OLLYDOTDEV/Project-Birdseye-DTX-2020/README.md

# Project-Birdseye-DTX-2020
The initial plan is to create a device that is made for the sole purpose of a Preemptive Security system for People who work with Confidential/Private Information and need to work on potentially more public places where one cant Guarantee fully secure/discrete room.    My Approach to solving this is with a wireless computing node  That Takes Sensor data from a variety of senses. Then the Data from the Senses is taken then and processed to determine whether there is a security breach if so then it will Relay that info over to the Raspberry Pi W that then Emulates an HID (Human interface device) Using the P4wnP1_aloa made by mame82 to Execute a custom user-defined action that will be set via  Apache server hosted of the Raspberry Pi W Communicating From a web interface back to the server via a web socket

 Projectbirdeye is out of the box working solution for this 
________
See for devlog of project [here](https://github.com/OLLYDOTDEV/Project-Birdseye-DTX-2020/issues?q=is%3Aissue+)
