OLLYDOTDEV/Project-Birdseye-DTX-2020/(threads)

Thread 2 (2020-06-03):

Atmega 328p

OLLYDOTDEV, 2020-06-03:
As a user
I want this to work out that is happened around the ROMS
why as the main point of this project is to work out whether there was been a breach of location as happened and react to it so something needs to calculate that something has happened.

OLLYDOTDEV, 2020-06-13:
Starting off to after I had worked out that I wanted to do  for this project

I was faced with how I was going to approach this component of The Project. From main projects, I knew that I was going to tackle the designing of the PCB with eagle cad but as for the actual device itself I had initially thought I would go with something like a raspberry pi zero w But decided that for something that is going to be run on battery power I would rather have something that is more efficient Powerwise, So I turned to look at Arduino’s and this was Looking around the promising option but the idea of having to buy A whole bunch of bunch sensors and also fit all compactly would have work but I was looking for something a little more flexible. I thought surely there is a better way to using Arduino, if Arduino was made from smaller Components surely I can do the same just have it more adapted to my project. So after further investigation, I have seen that The do we know Uno is based off the atmega328 DIP chip (Some clones use the TQFP version)

So when looking into getting an atmega328 to work first you need to burn the Arduino boot loader show in The variety of different ways here From Arduino to ATmega328. I will be using the FTDI Adapter Is something that needs to be kept the mind while doing this is the fact that The hardware pinout for this chip is

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

https://www.youtube.com/watch?v=kDL9CHratZE
This Image Shows the physical pinout of the chips but Confused and Confusingly the pin 1 of port pinout  does not Equal what can be seen for the function of the Pin as pin 1 Is a PWN pin Arduino is concerned it is pin ~D2

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

So next it to set up the needed external components see https://github.com/OLLYDOTDEV/Project-Birdseye-DTX-2020/issues/4

Closed 2020-06-15.

Thread 4 (2020-06-04):

External Components  (Atmega 328p)

OLLYDOTDEV, 2020-06-04:
As an electronics engineer
These extra components are needed to increase speed and stability for exected uses\
So that ROMS can be trusted as a security device by the user

OLLYDOTDEV, 2020-06-13:
continuing from #2

So there is the full layout for the pins. With this in mind, I am now proceeding to remake
https://www.arduino.cc/en/Tutorial/ArduinoToBreadboard
https://www.arduino.cc/en/Main/Standalone

Eagle Cad here I have added an image of the 16 MHz Crystal connected to ground

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

GIT[[added 16mhz +grounding](https://github.com/OLLYDOTDEV/Project-Birdseye-DTX-2020/commit/e12c5454263cb21ca886e1c202b559df976d1aeb)]

Crystal Oscillator work of the Piezoelectric effect. The Crystal needs to be connected to ground as crystal need grounding as when the crystal vibrates it can send a signal back down the connected wires to the ground nullifies these signals by redirecting them to ground The process of Grandma goes to a 20 microfarad Ceramic capacitor.
They provide a square wave signal which determines the time required for each T state

3.3v is Good for a max of 8 MHz
5v is Good for a max of 16 MHz

https://www.youtube.com/watch?v=YzcKQWwkzWs
https://www.elprocus.com/what-is-the-piezoelectric-effect-working-and-its-applications/

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
GIT[[added 16mhz crystal + grounding](https://github.com/OLLYDOTDEV/Project-Birdseye-DTX-2020/commit/93ae92d78ddcad249c48d75e36c7279c0da2040d)]

Here added is part of the Electrical relationships between VCC

GIT[[added .gitignore so that the temp .s#1, .s#2 files dont get uploard to upstream git repo](https://github.com/OLLYDOTDEV/Project-Birdseye-DTX-2020/commit/7e8b13f36523d23c00ed487ddc91489516e3ab27)]

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

Added reset headers that can be shorted to reboot the IC

GIT[[Start of NRF24lo1 hook up & LED](https://github.com/OLLYDOTDEV/Project-Birdseye-DTX-2020/commit/7bd8bc368a4d44dfbec3e38c69a0a2974c8d6d8c)]

next up #6

OLLYDOTDEV, 2020-06-13:
it should be noted that I will be running at 5v to allow my Atmega328p to run at 16 MHz giving me double the default processing speed and in turn quick reaction times removing one potential bottleneck, which is a critical consideration when time is at the essence do with security

Closed 2020-06-15.

Thread 5 (2020-06-07):

RGB Interface

OLLYDOTDEV, 2020-06-07:
As an engineer
this part of the IO Dedicated to sending signals to the LED on external PCB  needed
It is Impractical to LED's mounted directly on the main PCB and still has the LED display on the outside on the Protective case.

OLLYDOTDEV, 2020-06-13:
The initial plan was for the  display LEDs to be located directly on the main PCB  it was later decided that due to design restrictions it would be unlikely that you would be able to see the LEDs if they were located on the main PCB server the decision was made to make a secondary PCB to  how's the display LEDs that can be repositioned to the desired location when the case design is decided in #20

OLLYDOTDEV, 2020-06-13:
so with having an addition atmega328p on the secondary PCB (now called LC_Board)
To due lack of pins on the main atmega328p (for more info see #6 )
this atmega328p I have it dedicated to just controlling these lights and communicate via serial protocol back to R.O.M.S

OLLYDOTDEV, 2020-06-14:
Due to LC_board operations on 3.3v and the ROMS runs on 5v so when communicating over serial communication (TX and RX) pins on the used for this communication happen to also operate at the corresponding Voltages for each board. so I am going to need a real-time conversion unit eg something like [this](A Bidirectional Logic Level Converter (for I2C)) how they work[ explained here ](https://www.youtube.com/watch?v=t-yuYasIKtY&feature=youtu.be&t=349) Sparkfun does provide a [datasheet](http://cdn.sparkfun.com/datasheets/BreakoutBoards/Logic_Level_Bidirectional.pdf) on how there  [Bidirectioal logic level converter](https://www.digikey.co.nz/product-detail/en/sparkfun-electronics/BOB-12009/1568-1209-ND/5673795?productid=5673795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) would work as seen in the image below
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

OLLYDOTDEV, 2020-06-14:
In short how this work is frankly awesome

If you have 5v on the high end the then with the MOSFETs VGS being 0v (as both G and S are sitting at 3.3v there for no difference ) then the low will be pulled high and the low signal will be received as high but if the High was sitting at 0V then the MOSFET would turn on and the current would flow from low to high, and due to the fact that 3.3 is still counted as a logic high

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

Sure I Could I have you something like a dedicated chip with a 4-bit bus like a TXB0104

but the parts needed Logic Level Converter are also used in the rest of my project means that I happen to have his parts already on hand for when I do create it. So rather than being required to purchase another component, I could just use the surplus of my other components to achieve the same endpoint.

What is needed is a n channel MOSFET and a some 10K resters

OLLYDOTDEV, 2020-06-14:
First I needed to fix my eagle library for my MOSFET. This MOSFET .lbr from the git repo that I [sourced it](https://github.com/sparkfun/SparkFun-Eagle-Libraries/blob/master/SparkFun-Electromechanical.lbr) form as there where some labels that were missing on the n channel MOSFET

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
[before]

Here the pins are not labeled. To make this easier on myself so that I don’t have to keep working what pins are what. So here is the edited version

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
[after]

I didn't need to do this for the p-channel MOSFETs as they were all readily labeled on the Schematic
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

OLLYDOTDEV, 2020-06-14:
As for how the atmega328p on Roms will talk to the atmega328p on LC_Board we can look at how  Arduino's use with serial communication.

The **RXD** of the left PCB to the **TXD** of the right PCB
The **TXD** of the left PCB to the **RXD** of the right PCB

seen here
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

to starting of making the IO for the LC_Board

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

- GND is so that everything will have a common GND
- VIN allows to hook up to the battery input on the VIN pin this supports a max of 20v and around 1.6 A
-
- 5V_rail takes a pre knowen stable 5v this is used to provide power to for future version for latter projects, so it here for a future version that might need this so I am keeping my option open
-
- 3.3V_rail is for accepting a fixed input of 3.3 voltages or it can be used to be connected
-
- TXD is used for sending the serial data out from the PCB
-
- RXD_IN is for receiving serial data other from the PCB (refer to the 2nd image above)
-   to it opens
- Then there are two pins called 2BD this is short for to be developed And keeps my options open For further development
-

After Retrospect the IO needs a reset line for when hooking up my if FTDI chip (FTL232RL)for when I am to upload the program to the atmega328p chip. But that's why I added a 2BD(to be decided) pins
Here is an image of the  FTDI chip hooked up to an Arduino mini pro

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

So for my project this FTL232RL will connect to this pinouts

Here is CTS ,DTR ,BLK ,GRN. So before I continue, I am working out that these are.
So after talking with some people, it turns out that BLK & GRN if literally the color wire in the FTDI cable there are used for transmitting CTS and DTR data. CTS and RTS is used for a flow control, this is used for sending a high singal when the device is ready to receive more data but in my used case that is not needed.

CTS is ‘clear to send’ [this pin it not needed]
RTS is ‘ready to send’ [this pin is not used]

DTR is used for sending the reset signal to reboot the atmega328 chip once code has been uploaded

So here is my updated IO for the LC_Board
Git[[updated io](https://github.com/OLLYDOTDEV/Project-Birdseye-DTX-2020/commit/4a7a873846185fba254144686e5f116613a9eb19
)]
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

OLLYDOTDEV, 2020-06-14:
Added the reset in pin and also rearrange the layout so that it is a better match FTDI adapter.
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

Here I have haded the two headers for switching the input of RDI from being progressed as a 5v signal (jumper 2-1) on the left side and jumper (3-2) on the right. Whereas for 3.3v RDI input signage you want to put the jumper on the left (2-3) and on the right (1-2)

This is needed as the FTDI adapter will output an RDI of 3.3v. Were as the ROMS board will send a RDI of 5v that need to be converted to a 3.3v RDI before going to the Atmega 328p I have talk about how this will be done [here](https://github.com/OLLYDOTDEV/Project-Birdseye-DTX-2020/issues/5#issuecomment-643733966)

OLLYDOTDEV, 2020-06-14:
It should be noted that for LC_Board to run at [3.3v it will need to disable the brown out](https://arduino.stackexchange.com/questions/8733/what-are-the-implications-of-running-an-atmega328p-at-8-mhz-and-3-3-v-with-the-a) so what if doesn't to a chip force shutdown. http://www.engbedded.com/fusecalc/  lets you work out what to change.

OLLYDOTDEV, 2020-06-16:
With my change in plan as seen https://github.com/OLLYDOTDEV/Project-Birdseye-DTX-2020/issues/6#issuecomment-644453770  The interface will be changed to account for a new io to control the shift register

OLLYDOTDEV, 2020-06-16:
the changes that will be to be made for this interface are not to major as Shift Registers only need three pins for data (DS, ST_CP, SH_CP) and one 5v and GND. for the RGB I will still need 3.3v for it so I will keep it simply and use a level shifter make out of a 2K and 3k R resistor

OLLYDOTDEV, 2020-06-17:
To start [it is work reading this first](https://github.com/OLLYDOTDEV/Project-Birdseye-DTX-2020/issues/6#issuecomment-645112610). So with having the Shift Register in the LC_Board Schematic I am now about to see what Ports I need to use.

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

(IO)

For a start, I can remove the TXO, RXI, Reset_In and Vin pins this levels me with only GND and V5 pins

the three pins I need to hook up are
DS = data serial input // Found on pin 2
SH_CP =shift clock pulse // Found on pin 3
ST_CP = storage register clock pulse // Found on pin 4

 With those pins, I will be able to control everything I need to shift register with the STP16C596

A brief run down how the communication will be working
"How this all works is through something called "synchronous serial communication," i.e. you can pulse one pin-up and down thereby communicating a data byte to the register bit by bit. It's by pulsing second pin, the clock pin, that you delineate between bits. This is in contrast to using the "asynchronous serial communication" of the Serial.begin() function which relies on the sender and the receiver to be set independently to an agreed-upon specified data rate. Once the whole byte is transmitted to the register the HIGH or LOW messages held in each bit get parceled out to each of the individual output pins. This is the "parallel output" part, having all the pins do what you want them to do all at once." [arduino.cc](https://www.arduino.cc/en/Tutorial/ShiftOut)

OLLYDOTDEV, 2020-06-21:
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
(Updated IO)

Now with an IO changed to the new specifications.

Closed 2020-06-22.

Thread 6 (2020-06-07):

RBG LED’s

OLLYDOTDEV, 2020-06-07:
As a user
It would be highly convenient to have Device status feedback of the ROM'S
So what I Know that is happening and whether the ROM'S is ready to be used

OLLYDOTDEV, 2020-06-13:
https://octopart.com/598-8710-307f-dialight-868662#Specs
https://octopart.com/598-8710-307f-dialight-868662#PriceAndStock
Through many difficulties, I have managed to find CAD models and specs for the SMD RGB LEDs with the Component's name being 598-8710-307F. These LEDs are going to be used to output system status info to the user. Eg when batty need charing (also can send msg back to the computer and makes a pop-up, flash Red)

Design for this PCB is currently underway as LEDs.sch

the dialight LED's I am using happen to have 3 anodes per component once for each RGB LED
each of these anodes corresponds to a color, Eg R,G,B meaning to use the desired amount of three RGB LEDs that would require a total of 9 pins (1 per anode) on the ROMS atmega328p without having that amount of pins free it first thought I looked into was having on the additional PCB (as talked about in #5 ) an addition atmega328p microprocessor that acts as a node that branches off the Primary atmega328 allowing for the much-needed pins to control the LED's. https://github.com/OLLYDOTDEV/Project-Birdseye-DTX-2020/issues/5#issuecomment-643613012 will go into greater detail how this will work for connecting the two chips

OLLYDOTDEV, 2020-06-14:
I needed a way to control the first method that comes to mind. It is simply just powering the LEDs directly from the main IC(https://github.com/OLLYDOTDEV/Project-Birdseye-DTX-2020/issues/2#issuecomment-643586762 ). There should be there is that the atmega328p that I'm using operates at 5v and that would completely fry the leds as they are rated for about 3.4v

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
(The part name is DIALIGHT_598-8710-307F we can see that has 3 forward voltage values
This is for each of the three colors each there
And each color has a differce volage useds
)

OLLYDOTDEV, 2020-06-14:
A concept to approach in this issue was a plausible solution using Pulse width Modulation (PWM for short) On a half duty cycle of 5v it would hypothetically could maybe be averaged via a capacitor as seen [here](https://www.arduino.cc/en/Tutorial/PWM). I'm going to be inquiring to the teacher about this So that I can get a solid answer that way I can get a definite answer, ok well yes that has potential there is too many things I could go wrong with acting as an irregular power supply.
so after looking into this more yes it might work but firstly it would provide a way too much amperage as the LED at max can only handle 30mA and 5v from the Atmega328p can be at great as 200mA just under 20times. so it would be no good

OLLYDOTDEV, 2020-06-14:
https://github.com/OLLYDOTDEV/Project-Birdseye-DTX-2020/iissues/8#issuecomment-643705732
With using the LDO regulators going to control the voltages I can now get back to working out how to control the LEDs as stated in https://github.com/OLLYDOTDEV/Project-Birdseye-DTX-2020/issues/6#issuecomment-643615355 . Whats better to control something then a switch so how about an Electronics switch such as transistors
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

In short, a MOSFET is a Fancy transistor

but when comparing the base of a transistor to the Gate MOSFET can be seen that there is actually a physical connection where and drainage from that pin would occur would just be a waste of power. So An alternative is to utilize a MOSFET which utilizes The effect of inducing a current flow  via magnetic fields, once though capacitance is charged there's no need to continue providing power as there is no discharge, therefore, there is minimal to no loss-making it super-efficient Circuit

That is why I have picked MOSFET over transistors
So I started looking it to information about MOSFET
https://oscarliang.com/how-to-use-mosfet-beginner-tutorial/ was a good place that helped me a lot to understand how they worked

OLLYDOTDEV, 2020-06-14:
So for starting there are two types n-channel and p- channel
There are used in the two Different scenarios given below
(info from [youtube](https://www.youtube.com/watch?v=ZklK5DaIOaI))

In short, PNP is when the switch is placed be for the connected load, in my case, a MOSFET is out equipment switch. therefor the placed between the VCC of the load as seen here.
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
where as NPN is the opposite
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

There is also the mode that you need to consider as there are [two types](https://www.allaboutcircuits.com/video-lectures/mosfets-mos-field-effect-transistors/)

I will be going with enhancement-mode MOSFETs as in project is it is battery operated as having a content drain from a depletion-mode MOSFET (these are more like a variable resistor) would be the incorrect use for this component and Inefficient.
[Enhancement-mode MOSFETs](https://www.youtube.com/watch?v=l9LBIy9Ioxo)Work by when a sufficient voltage is applied to the gate (the amount of voltage changes from MOSFET TO MOSFET) it will Induce magnetic field in p material as the seen here.
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

Which in turn allows for current flow from the source to the drain. - in a circle is repetitive of current flow as electrons  are negatively charged
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

OLLYDOTDEV, 2020-06-14:
So with this in mind this there is more to consider when picking a MOSFET for your project

Gate threshold otherwise knowen as [Vgs(th)](https://www.allaboutcircuits.com/technical-articles/understanding-mosfet-on-state-drain-to-source-resistance/) is a point where the MOSFET will start to conduct current but with high resistance. gate-source voltage is scaled to allowing more current through once your parcel point. eg within a given range more volage at Vgs(th) =  Is an inverted depletion curve ratio.
[Understanding MOSFET On-State Drain-to-Source Resistance - Technical Articles](https://www.allaboutcircuits.com/technical-articles/understanding-mosfet-on-state-drain-to-source-resistance/)
[Topic: n-channel / logic level / low Rds MOSFET - and datasheet questions](https://forum.arduino.cc/index.php?topic=465934.0)
[n-channel / logic level / low Rds MOSFET - and datasheet questions - Page 2](https://forum.arduino.cc/index.php?topic=465934.15)
[Topic: About the good usage of N-channel MOSFET ](https://forum.arduino.cc/index.php?topic=51916.0)

[RDS(on)]( https://www.youtube.com/watch?v=P_5kPfwzT80) idea seems simply when the gate is off the resistance between source and drain is extremely high—so high that we assume zero current flow. This scales as more voltage applied to the gate pin the more current can flow through from Source to drain (Until blows itself up due to much voltage, not recommended )

Logic level MOSFET vs normal MOSFET
[MOSFET Confusion - Logic Level vs. Standard
](https://www.avrfreaks.net/forum/mosfet-confusion-logic-level-vs-standard)
[Logic level vs "normal" MOSFETS](https://www.electro-tech-online.com/threads/logic-level-vs-normal-mosfets.91756/)

to put it simply means what the Mosfet runs from the approximate 3.3 to 5-volt value on the [gate to Source ](https://electronics.stackexchange.com/questions/75516/determining-the-maximum-gate-voltage-for-an-n-channel-mosfet
)Rather than higher values like 10v switch and microcontrollers typically don't normal output natively higher than logic level voltage.

So as long as the RDS(on) Met in the gate is provided sufficient power Then we should be fine
This is important as I will be needing To drive MOSFETs at a logic level (3.3v or 5v) so the RDS(on)

Here's a breakdown some [Main parameters of a MOSFET](https://www.embeddedrelated.com/showarticle/809.php)
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

OLLYDOTDEV, 2020-06-14:
Making sure that you use the right specs for a project is important to know. this info can be obtained by looking at graphs. To confirm my finding I talked to someone who works in the electronics industry.

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
(Conversation took place 20/02/20: 9:50 pm with A certified  electronics engineer with a degree from university who is actively working in the industry as well)

Armed with this knowledge I feel I'm able to make an informed decision on watch component more explicitly which MOSFET would be the best option for my particular use-cases while considering things like budget, usability, flexibility, and accessibility

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

OLLYDOTDEV, 2020-06-14:
I will be going a SOT-23 footprint due to its sizes so the two MOSFETS I am looking at getting will both work at 3.3 and 5 Volts making them very Versatile and reusable within this project. for my N channel MOSFET, I will be using a [N channel: BSS138](https://nz.mouser.com/datasheet/2/308/BSS138-1300116.pdf)
and for my P channel MOSFET, I will be using a P channel: [DMN65D8L](https://www.diodes.com/assets/Datasheets/DMN65D8L.pdf)

OLLYDOTDEV, 2020-06-14:
here it was the RBG LED look with when hooked up to MOSFETS within Eagle CAD schematic view
(the gate voltage for the MOSFET is driven by the digital pins on the atmega328 )
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

Below is the pinout if the atmega328p
The brown pins with 0 to 13 are all digital pins i could use.
But due to the fact i am also going to need some of this for the serial interface for connection with the R.O.M.S these pins are the RXD and TXD pins i made a note not to use them
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

I have selected pins (D then the number is The corresponding pin on the atmega328p)-(this is the color it is controlling)

D5 - Red -
D6 - Green -
D7 - Blue -

D8 - Red -
D9 - Green -
D10  - Blue -

D11  - Red -
D12 - Green -
D13 - Blue -

As according to this datasheet anyway
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

OLLYDOTDEV, 2020-06-14:
After used eagle cad to take the prior defined Electrical connection from my schematic file and then used the parts footprints and converted them into a .brd file this file is used for defining the physical relationship for the parts and physical wires.

They started all jumbled but after some Shuffling of parts this is what it looks like
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

Here we can see that i cam starting to get the parts into there groups

Eg

Power, Led, io, etc

All the yellow lines that can be seen are called air wires. These are used to Show the electrical relationship between components that define the physical wires between them.  the routing tools used to add the physical wires. In a relatively simplistic Circuit like this then you can use a function called autoroute which essentially utilizes the computer to generates the most efficient pass between components without having any overlaps.
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

Above you can see the outcome of utilizing autoroute did a pretty decent job of looking at everything consider That I had to place only components in Rough groups.

After revision, I have looked at all other Opportunities to Start shrinking my board design and optimize it more here is the next revision

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
On the left, I have compressed the headers for selecting the 3.3 volts or the 5-volt RDI as well as trying out a new method of compressing the LEDs and MOSFETs on the right.

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

Again compacting the left side down more while trying to maintain it at a scale which I can still realistically make my hand

OLLYDOTDEV, 2020-06-14:
Seeing as I want the LED to be flush with the case where I needed to move the led from the top of the PCB (red color) to the bottom (blue color).
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

Here on the (image above), I have moved the RGB LEDs to the back as seen in blue. The wires were placed by autorouter and are very messy. The need for the wiring to be tidy is the PCB at a later date. So to achieve this I will wire this by hand.

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

The (image above) there is an image of my manually Connected wires that have resulted in a Uniform Circuit Layout.  So yes sometimes it does pay to do things by hand. [Spark fun guide](https://learn.sparkfun.com/tutorials/using-eagle-board-layout/all) helped a lot here on how to do a good looking job. If if you compare the image just above to the one above the image that contains all 9 MOSFETs  you will see a major difference in the layout
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

Here is everything looking nicely wired by hand

OLLYDOTDEV, 2020-06-14:
Throughout the process of green the PCB, I may have renamed some names without the schematic editor open therefore they became essentially two different versions of this PCB and the result is that the difference is created and one edited did not sync to the other and earn of this I now have to go through manually fix errors, to prevent this in the future from happing I need to have a feedback loop enabled this can be simply achieved by just have the Schematics editor open as well as the board editor

 open at the same time
as fixing this was a poor use of my time 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
GIT[[Syncing schematic with board fixed](https://github.com/OLLYDOTDEV/Project-Birdseye-DTX-2020/commit/0adb82384fae904a645e03be3eee91c073322475)]

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

Git[[R1 Finish (yet to test)](https://github.com/OLLYDOTDEV/Project-Birdseye-DTX-2020/commit/026b4fea1fb36c3496c9733880ad8f4e927f4855)]

Here R1 for LC_board is complete and parts need to order so that construction can commence, till then see Construction process to see the physical development of this board

(added all needed part to part list on google sheets found in 2020 DTX For Oliver page Components and power calculations.)(at time of write this it is on google drive but will be backed up to GitHub once the project is complete )

Also with this daughter board of the ROMS designed. The next step in to continue the ROMS PCB  designing so I can then continue with the construction process

OLLYDOTDEV, 2020-06-16:
After the sprint review (with me. myself and I), it was noticed that while the proposed design work would and achieve the aim of the user story. Between when I started designing this part of the project found a circuit called [shift registers](https://www.arduino.cc/en/tutorial/ShiftOut).This would allow me to make LC_Board cheaper, simpler, and even better it will make it easier to produce. Therefore this second sprint I will be focusing on remaking LC_board to use a shift register.

OLLYDOTDEV, 2020-06-17:
To start off with the shift registers I will be changing my the IO from [#5](https://github.com/OLLYDOTDEV/Project-Birdseye-DTX-2020/issues/5#issuecomment-643737385) and also removing everything else other then the LED from the Schematic. Next, I need to add my level shifter, the level shifter I have picked to use is the STP16C596 in the TSSOP24 SMD package. I have chosen this chip over other mainstream chip such as the 74HC595 due to the need to use 9 pins and a chip like 74HC595 can only control 8 pin so have gone with the STP16C596 it can control 16 pins all at once, yes you are able to just use two 74HC595 but I am trying to keep down the cost as this is an implication that I am keeping in mind so using two 74HC595 would firstly cost more and also would take up more space there for making the STP16C596 a better choice.

but the next issue I found was that STP16C596M doest have a part file for eagle cad so as a fix to this I made my own on [https://ms.componentsearchengine.com
](https://ms.componentsearchengine.com) from this I was able to generate STP16C596M.lbr this can be found in Project-Birdseye-DTX-2020/Schematics/libraries/STP16C596M.lbr

with this, I was now able to import the IC into the LC_Boad.sch

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

OLLYDOTDEV, 2020-06-21:
Ok so with the IO needed for the level shifter sorted out in https://github.com/OLLYDOTDEV/Project-Birdseye-DTX-2020/issues/5#issuecomment-647071016 it connects them to the IC. To do this we can look at Table 3 on the STP16C596M [Datasheet ](https://www.digchip.com/datasheets/download_datasheet.php?id=938538&part-number=STP16C596B1R)

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

From here it can be seen that Power Pins are
GND = Ground terminal // Pin 1
SDD = Supply Volage Terminal // Pin 24

From here it can be seen that that for the main input- pins that we care able are

SDI= data serial input //  Pin 2
SH_CP =shift clock pulse // Pin 3
ST_CP = storage register clock pulse // Pin 4

Data Pins that would tied to a fixed voltage
/OE = Output enable // Pin 21 // PUllED DOWN LOW

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

These pages were used to check the pin hook up to the [datasheet](https://www.st.com/resource/en/datasheet/cd00005085.pdf) as it is better safe than sorry.
https://phanderson.com/arduino/stp_596.html
https://www.arduino.cc/en/tutorial/ShiftOut

OLLYDOTDEV, 2020-06-22:
now time to get back to hooking up the LEDs so they can be controlled. Now knowing that STP16C596  has 16 togglable outputs, at first it was my thought to connect the anode (positive) then bam but yeah no , if only things were that easy.
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
(Common anode RBG LED)

well they would be it I was using an RGB led with a Common Anode (shown above) but it is cheaper at get a Common cathode RGB LED as (shown below) there for keeping within the implications of this project I am keeping the costs down.

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
(Common cathode RGB LED)

To my approach to this is use the fact that the + of current to the point of low charge (eg Ground or the Negative of a battery) So by connecting the output pins from the STP16C596M  in the cathodes of the LED's I will be let me control the flow of the current. When a pin for the Shift register is high(5v) then there will be greater (due to STP16C596M  running at 5v and the LED at only 3v) electric potential difference there for with no current flowing the LED and in turn, will turn off. Whereas if the pin from the Shift register is set to low then there will be an electric potential difference thought the LED and current will flow and hence the LED will produce light. Sure yes it is  backward to how one would normally think to turn on and off of LED but it should work (prototypes of example circuits were used to test the therory behind this) have the control be inverted is no issue due to the fact that code https://github.com/OLLYDOTDEV/Project-Birdseye-DTX-2020/issues/7 will be able to compensate

OLLYDOTDEV, 2020-06-22:
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
Here the LEDs have been connected to OUT put pins Shift register. I have done as much testing as I can with parts I have on hand put the key to this is yet to be tested. the Key is for the Shift register to be bidirectional so when they are not providing power they hopefully and act as a path to ground. this will be tested one the shipment of parts has arrived still then this sprint is at an end and will need to be reopened once the appropriate components in unavailable to be tested/prototyped

https://github.com/OLLYDOTDEV/Project-Birdseye-DTX-2020/commit/38e38a723ac9d003f8767095b455d9875b63956c

Closed 2020-06-22.

Thread 7 (2020-06-08):

LED control code

OLLYDOTDEV, 2020-06-08:
As a programmer
I need to add some control code to convert the current drive status to a LED output
So the LED's added in https://github.com/OLLYDOTDEV/Project-Birdseye-DTX-2020/issues/6 will be able to reflect the Current drive status

OLLYDOTDEV, 2020-09-23:
dim unnecessary to develop while still on Prototype stage in the did not provide the most value to the customer/due to the ad job process trying to provide whatever is going to provide the most value to the customer

OLLYDOTDEV, 2020-09-23:
never left prototype stage from the breadboard combined with the project running out of time the it'll be no longer developed

Closed 2020-09-23.

Thread 8 (2020-06-09):

Battery

OLLYDOTDEV, 2020-06-09:
As a user
There needs to be some way that ROM's from work without the need for it to be plugged directly into the source of external power.
So a fix would be to add some sort of battery to the system

OLLYDOTDEV, 2020-06-13:
At first when Research started into providing power to ROMs it was decided that there will need to be some sort of capacitor to smooth out the waves  coming from the power source As the act a bit of a Reservoir  as in when there is a lack of energy days are able to provide a small boost and when there is the increased it is able to absorb some of that excess energy

OLLYDOTDEV, 2020-06-13:
Talk more about the physics behind sine waves and Pulse width modulation
https://www.allaboutcircuits.com/textbook/alternating-current/chpt-7/square-wave-signals/
Square waves are equivalent to a sine wave at the same (fundamental) frequency added to an infinite series of odd-multiple sine-wave harmonics at decreasing amplitudes.

OLLYDOTDEV, 2020-06-13:
That then raises the question of how I am going to power the ROMS and its core components #2 , #4
For this, I will be needed to provide two volage levels a 5v rail and also a 3.3v rail so for this I thought I would play it on the safe side and use two [CR2032 - 3V](https://www.aliexpress.com/item/32894761648.html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,searchweb201602_,searchweb201603_) due to there small size and a total output of 6v or does it
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

Volage discharge rate chart (top image)
CR2032 N placed in series resulting in 6 volts (bottom image)

As seen in The image above initially the coin battery starts off what's above 3 volts around 3.2v. Since I will be running two of these and parallel will give me 6.4 When fully charged (new) And this could completely fry any regulators if you were just basing the typical output on his average discharge voltage. So where I had initially thought hey 3 + 3 is 6 OK let's get a regulator that is writing for a maximum of 6 volts recalculating and with that I needed the minimum  Of at least (having more overhead is find )7 volts best safe So not too fry my components as the only rated for Max of 5 volts or 3.3v. To prevent this I am looking at USING two  3.3 (for this led PCB,https://github.com/OLLYDOTDEV/Project-Birdseye-DTX-2020/issues/6#issuecomment-643615355,https://github.com/OLLYDOTDEV/Project-Birdseye-DTX-2020/issues/5#issuecomment-643613012) and 5 volts (for ROMs,https://github.com/OLLYDOTDEV/Project-Birdseye-DTX-2020/issues/2) regulators

Now time to research more sort of regulators there are out there and what suits my purpose best

OLLYDOTDEV, 2020-06-14:
After coming back from https://github.com/OLLYDOTDEV/Project-Birdseye-DTX-2020/issues/8#issuecomment-643615584 and looking into regulators I have found that there are 3 Primary types of [Voltage Regulators ](https://www.lifewire.com/types-of-voltage-regulators-818851)

Linear Regulators
Switching Regulators
Zener Diodes
[Buck converts](https://en.wikipedia.org/wiki/Buck_converter)

In the end, I Decided To go with a Low dropout Linear Regulators. So I due to the fact that my input voltage of 6v is close to the 5v I can Afford to use Low Dropout Linear (LDO) otherwise the heat as any extra voltage is converted to heat so with having only

The main pro with this is the fact that they are simple/cheap / produce low noise as just said the only issue is that any excess voltage gets turned into heat there for giving them limitations and but this is not an issue in low voltage appliances where the low supply voltage and is close to the voltage out and when you require low noise environment. Which is exactly my use case.

From past projects, I have found that a good place to start of looking for parts is [Digikey](https://www.digikey.co.nz/en/product-highlight/s/stmicroelectronics/ldo-regulators
LDO)(Low Dropout Linear Regulator)

After looking on Digikey and not finding what I am looking for I took to google
And found [this page](https://www.analog.com/media/en/technical-documentation/data-sheets/1763fh.pdf). It houses the datasheet for a series of LDO’s

I have a choice to use
LT1763CS8-3.3 to provide 3.3v rail and LT1763CS8-5 for 5v rail
These LDO have 8 pins, four each side.

These pins are
BYP (Pin 6/Pin 4)
 achieve low noise performance from the regulator if not used do not connect pin
06

IN (Pin 10, 11/Pin 8)
(VIN is the completely unaltered input power before the regulator)

Power into regulator
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

I will be Replicating the circuit in below in Eagle for
LT1763CS8-3.3
And
LT1763CS8-5
Libraries have also been added
LT1763CS8-3.3_TRPBF.lbr
And
LT1763CS8-5TRPBF.lbr
So that the schematic has the needed parts from the [datasheet](https://www.analog.com/media/en/technical-documentation/data-sheets/1763fh.pdf)

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

 The bypass pin is not utilized due to the fact that it is only needed for when you're trying to achieve lower noise to Signal ratio and these LDO all ready have a signal to noise sufficient to my needs

it should be noted that it was considered to uses
resistors to make a volage to make a voltage divider to drop the volage

OLLYDOTDEV, 2020-06-14:
With the [power delivery designed ](https://github.com/OLLYDOTDEV/Project-Birdseye-DTX-2020/issues/8#issuecomment-643705732) The now I need to implement it to my schematics
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
Some other things to keep in mind is that I also need to take 6v From ROMS to the LC_Board via #5

It was thought able having the 3.3v regulator on the ROMS then send 3.3v to LC_board but It

It occurred to me that rather need to redesign a very similar item in a future project that it should be designed to be able to work independently of other components and be a standalone subsystem as will be seen in #6 .

OLLYDOTDEV, 2020-06-14:
This marks the completion of Of the first implementation of the Schematic
git([power system for the LED](https://github.com/OLLYDOTDEV/Project-Birdseye-DTX-2020/commit/8a63fe896f22e3a90d1ba206198f2dcbb4598356))

OLLYDOTDEV, 2020-06-16:
So after viewing at the end of sprint meeting with my self I work out that some of the need parts for the battery/power system can no longer be brought due to COVID-19

https://github.com/OLLYDOTDEV/Project-Birdseye-DTX-2020/issues/11#issuecomment-644455695 so no longer with access to my first choice of power regulators I am will have to drop the supplied voltage to the ROMS PCB down to 4.5v from 6v. 4.5 voltages will be provided by 3 AA batteries giving around a nominal voltage of 1.5 voltages * 3 gives me the needed next best case.

To deal with any power fluctuation I will use a 10uf 50v capacitor to normalize the output voltage by holding any extra check that might occur with a power spick but also hold some charge so that if there is a small dip in the output voltage it is able to make up for the lost of voltage and keep it at an equilibrium

Closed 2020-06-22.

Thread 9 (2020-06-09):

Battery Meter

OLLYDOTDEV, 2020-06-09:
As a user
ROMS should be able to show the user what the battery charge is
As otherwise there is a risk of ROMS powering down due to lack of power and in turn not performing as expected

OLLYDOTDEV, 2020-09-23:
never left prototype stage from the breadboard combined with the project running out of time the it'll be no longer developed

Closed 2020-09-23.

Thread 10 (2020-06-10):

Voltage level reading

OLLYDOTDEV, 2020-06-10:
As engineer
To use the added Hardware of the Battery Meter from https://github.com/OLLYDOTDEV/Project-Birdseye-DTX-2020/issues/9 I need to have a conversion layer so that analog voltage is converted to values that is able to be used by https://github.com/OLLYDOTDEV/Project-Birdseye-DTX-2020/issues/7 in turn showing the status of the device.
So that there is more useful data can be displayed   .

OLLYDOTDEV, 2020-09-23:
never left prototype stage from the breadboard combined with the project running out of time the it'll be no longer developed

Closed 2020-09-23.

Thread 11 (2020-06-10):

Power Regulation

OLLYDOTDEV, 2020-06-10:
As an Engineer
To prevent a hardware/ software failed as this can happen due to unreliable power fluxation
So having something to Regualat the provided power would, in turn, make this a more reliable platform

OLLYDOTDEV, 2020-06-15:
this was solved in https://github.com/OLLYDOTDEV/Project-Birdseye-DTX-2020/issues/8#issuecomment-643615584

OLLYDOTDEV, 2020-06-16:
due to COVID-19 some changes to are going to be able made as I no longer can buy the needed Power regulator.

OLLYDOTDEV, 2020-06-17:
https://github.com/OLLYDOTDEV/Project-Birdseye-DTX-2020/issues/5#issuecomment-644662839 I bring up the fact that I will still be using 3.3v on the LC_board but I won't have a voltage regulator on it so I will be using a voltage divider. to calculate the value of the needed resister I will be using
this formula
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
to make my life easier I will be using this [voltage divider calculator](https://www.allaboutcircuits.com/tools/voltage-divider-calculator/ )

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

so with an input Vin of 5v
If it set R1 to a 2K Ohms
and R2 to 3k Ohms
With these values
Giving a Vout (output voltage )of 3 Voltages Which is within the save usage range for my LEDs

OLLYDOTDEV, 2020-06-21:
Power for LC_Board will be coming from the primary PCB from within ROMS.  As said https://github.com/OLLYDOTDEV/Project-Birdseye-DTX-2020/issues/11#issuecomment-645130640 I will be using a voltage divider,  in doing so I take my 5v_Rail from the [IO](https://github.com/OLLYDOTDEV/Project-Birdseye-DTX-2020/issues/5#issuecomment-647071016)
and hook it up to the voltage divider giving be the needed voltage to
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
here is the voltage divider made Eagle cad within LC_Board.sch

Closed 2020-06-22.

Thread 12 (2020-06-10):

Sensors

OLLYDOTDEV, 2020-06-10:
As an end-user
I need ROMS to be able to detect in a variety of situations. in turn, be able to handle the information for the Sensors depending on the situation.
This is so that any private/secure information is protected.

OLLYDOTDEV, 2020-06-25:
While working out what IR sensor I was going to use for #14 I happen to run need to run some tests for this there was some test code that I produced.  See https://github.com/OLLYDOTDEV/Project-Birdseye-DTX-2020/issues/14#issuecomment-649520131 for more info about what it does but this code. It is most likely that some version based on this code will be using when developing this full code for the sensors

OLLYDOTDEV, 2020-06-25:
https://github.com/OLLYDOTDEV/Project-Birdseye-DTX-2020/issues/14#issuecomment-649520131

OLLYDOTDEV, 2020-06-29:
if (IRdatacount >= IRcheckcount) {

}

So I started off looking if anyone had made the code I was looking for everyone seemed to say that is what I was looking for [http://www.arduino.cc](http://www.arduino.cc/en/Tutorial/Smoothing)

so I have it a test

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

and it worked flawlessly as there is no dips in my values, am I surprised not really as this code is found on the official Arduino page
```
/*
  Smoothing

  Reads repeatedly from an analog input, calculating a running average and
  printing it to the computer. Keeps ten readings in an array and continually
  averages them.

  The circuit:
  - analog sensor (potentiometer will do) attached to analog input 0

  created 22 Apr 2007
  by David A. Mellis  <dam@mellis.org>
  modified 9 Apr 2012
  by Tom Igoe

  This example code is in the public domain.

  http://www.arduino.cc/en/Tutorial/Smoothing
*/

// Define the number of samples to keep track of. The higher the number, the
// more the readings will be smoothed, but the slower the output will respond to
// the input. Using a constant rather than a normal variable lets us use this
// value to determine the size of the readings array.

const int numReadings = 20;

int readings[numReadings];      // the readings from the analog input
int readIndex = 0;              // the index of the current reading
int total = 0;                  // the running total
int average = 0;                // the average

int inputPin = A3;

void setup() {

  pinMode(inputPin, INPUT);
  // initialize serial communication with computer:
  Serial.begin(9600);
  // initialize all the readings to 0:
  for (int thisReading = 0; thisReading < numReadings; thisReading++) {
    readings[thisReading] = 0;
  }
}

void loop() {
  // subtract the last reading:
  total = total - readings[readIndex];
  // read from the sensor:
  readings[readIndex] = analogRead(inputPin);
  // add the reading to the total:
  total = total + readings[readIndex];
  // advance to the next position in the array:
  readIndex = readIndex + 1;

  // if we're at the end of the array...
  if (readIndex >= numReadings) {
    // ...wrap around to the beginning:
    readIndex = 0;
  }

  // calculate the average:
  average = total / numReadings;
  // send it to the computer as ASCII digits
  Serial.println(average);
  delay(1);        // delay in between reads for stability
}

```
for anyone who does under here a good brack down on [how it works](https://www.programmingelectronics.com/tutorial-23-smoothing-data-old-version/)

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

now that is a big change mainly from the fact that we can see that our noise floor is now above 60, therefore, increasing the reliability of the values that we receive hopefully reducing/ if not completely removing all values that would give false positives.

OLLYDOTDEV, 2020-06-30:
it was all so considered to use a system that works on the bases of this pseudo code
```
first, remove key 0 of array
shuffle all key of an array down
add a new key with new sensor data

get a total of all the key added together
then take a total and divide to get the average
```
while in theory, this would work if I wasn't using a microcontroller with 2K of ram but I am so in the interest of to saving processing power and storage I will not be using a shuffling method also note that C++ is not made to be used dynamically but rather fixed (this decrease the needed resource overhead and means that this is great for IC ) as one an array has been made with a fixed amount of values you can't easily change the array to have less or more keys but only change the content of the data at key value.

OLLYDOTDEV, 2020-07-03:
I had mentioned that #14 I could get a 32 cm Range but that was under lightly controlled conditions but ROMS  is not going to be used in a controlled environment and hence the real-life in day to day environments are more like  3 to 8 cm as every environment is slightly different to the next to fix this the sensor could be recalculated automatically but adjusting the potentiometer, in that case, it would make sense to use a digital potentiometer that can be controlled by an atmega328p. now this would have a layer of complexity that while it would allow for the greater flexibility due to increased range as hoped for it is more practical to use a more reliable signal at the cost of range via

1. having a default setting where it is ok in most environments
or also having the option
2. to configure the IR sensor manually if better range is needed

OLLYDOTDEV, 2020-07-07:
So something I have found is that old light bulbs happen to give off IR light off that means that I can no longer to option one and I need to have a setup config mode as one of my relevant implications functionality in this case functionality is being flexible to work and multiple locations without restrictions

OLLYDOTDEV, 2020-07-07:
So while the IR sensor I am using does have an ADC onboard I am not happy with the value that it considers a low and high therefor I am reading the raw sensor data and give me the ability to control what is considered a 0 or 1[here is the code I used](https://github.com/OLLYDOTDEV/Project-Birdseye-DTX-2020/commit/ca5416f2f532c82813f2800dc5807e405ef67729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) next is to add a configuration mode where rather to sending out values it calibrates self

OLLYDOTDEV, 2020-07-07:
the calibration function has been now implemented the variable calibration_trigger controls whether or not the sensor will stay with local environment to set the IR sensors sensitivity or. it will pass on the signal to the relay
1 = calibration mode on | 0 = calibration mode off

to calibrate the sensor
put ROMS the desired Max distance a value under 12 cm is good
then turn the potentiometer on the sensor clockwise till it can be turned clockwise no more
next slowly turn anticlockwise to indicator LED turns off
then turn clockwise again just enough for the led to turn back on
DONE
 the sensor is calibrated for the environment

OLLYDOTDEV, 2020-07-07:
example on how to calibrate is shown here
https://youtu.be/vRiN55FDCng

OLLYDOTDEV, 2020-07-17:
This issue and #13 have been moved to milestone 4 (sprint 4) as the time need to complete them undercalulated and they needed to be moved to the next sprint as they at what provides the move value.

OLLYDOTDEV, 2020-07-19:
here is the sensor subsystem. it has been making to keep working and send keep send data so that whenever that when if the atmega328p does error out when it comes back up it the sensor all ready power on while this does have the drawback of some power loss due to Quiescent Current. the trade-off is worth it as 3 seconds mean all the difference.  When fist started off I had thought to try and minimize quiescent Current to try and maximize the battery life but in this latter version I am just keeping parts like the PIR and IR sensor powered so that as soon as the control IC is online we will be in back to business is is acceptable as the sensors picked in #13 and #14 both have low  Quiescent Current.

OLLYDOTDEV, 2020-07-19:
with the hardware for here sorted it is time for being.

I need to bring the software together that sets a state of being triggered which then can later be detected with #17.

OLLYDOTDEV, 2020-07-19:
in short this stage sorta just take parts from my test code and mergers in together.

so my taking pir_test.ino, IR_Sensor_Conf.ino, and SMOOTH_DATA.ino
(all off these files can be found here in the Project-Birdseye-DTX-2020/CODE/TESTING)

code from pir_test.ino will be used to control the input from the PIR sensor

from this here is what needs to be done
- [ ] add boolean for whether the PIR sensor has been triggered or not
- [ ] adapt IR code to use a boolean
- [ ] make SMOOTH_DATA.ino into a function

OLLYDOTDEV, 2020-07-21:
explain more on the smooth data. it is what I am using on the IR sensor to make my reading more accurate by taking an average over an amount of time. The base of this code was found open-source here  http://www.arduino.cc/en/Tutorial/Smoothing

starting to I need to make it function. todo this need to first make it so that values to be pass to the function to latter have an output return the smooth data

OLLYDOTDEV, 2020-07-22:
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
here is the basis of a function.

so I'm my case for the parameters I am using are is readings is all that would need to be passed

OLLYDOTDEV, 2020-07-22:
change of plan instead of making a function I will be using object-oriented programming and uses a class to make a blueprint as such as needed for the likes of 2.7 for NCEA but it also has the added benefit of allow me to reuse this class on more then one sensor if needed in the future keeping my options open for later development or for future developers spick up and continue the project as this is open source as accessibility in open source and just general availability to everybody as one of my implications

OLLYDOTDEV, 2020-07-22:
while testing on how to get class's to work I have moved this testing into a new file called Smoothing_class_test.ino
once this is working I can copy the working parts of the code i need into the main full test file

OLLYDOTDEV, 2020-07-23:
here you will find my test [file](https://github.com/OLLYDOTDEV/Project-Birdseye-DTX-2020/blob/38f92176e339dc9b9d3086bd4498b3718d2488ed/CODE/TESTING/Smoothing_class_test/Smoothing_class_test.ino).

in short, the point of it is test was to see how the structure for the copy for a c++ class would integrate into my project. Gudies online prooved mainly unhelpful with assisting this it was found to be more useful to take the [example code ](http://mypractic.com/lesson-7-classes-in-c-language-for-arduino-button-as-an-object/ ) and reverse engineer. Due to not having access to my hardware, I can't test if this code produces the same desire output. this will be done latter tonight

OLLYDOTDEV, 2020-07-23:
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
and here we have with a working version off data smoothing as found on http://www.arduino.cc/en/Tutorial/Smoothing but rather in the manipulated into a form of a class to increase for future flexibility for me for other developers.
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
to check that that the code had been correctly converted to be used as a class i am using DDT or otherwise known as test-driven development.

OLLYDOTDEV, 2020-07-23:
so with this get up there is an example of how the class works.

to make a object for it is a easy as

 Class name       object name (of you choice)
`AnalogSmooth IRsensor; `

now that we have a object name
we just need to call that object name  + the method we want to use

so ` IRsensor.Smooth_setup();` and BAM the IR sensor is set up and ready to have its input be smoothed and have some of the extra noise removed.

OLLYDOTDEV, 2020-07-23:
next step is to take this smoothing code and add it into the main testing code as talked about here https://github.com/OLLYDOTDEV/Project-Birdseye-DTX-2020/issues/12#issuecomment-660609183

OLLYDOTDEV, 2020-07-23:
well adding the smooth class to the header file went smoothly and there was no issue with it. but having a reliable data source revealed that the logic for the code was floored and needed to be revamped. eg i missed name a variable and was when it was looking if a status went high it would loop as once it was toggle high there was no method and plays for it to be reset

so started off I have added a part just for debugging to allow me to find issues with more ease with developing this code

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
verbose debug

otherwise here is the heart of it
``` C++
// IR code
IR_DATA = IRsensor.Smooth(IR_OUT);

if(IR_DATA < IR_Threshold){
// if this if statement activates that means that the sensor has been triggered
IR_Status = 1;
}else{
IR_Status = 0;
}

// pir code
Pir_Data = digitalRead(Pir_Out);
if(Pir_Data == 1){ // if PIR sensor actavated then set the alert status to active (true)
Pir_Status=1;
}else{
Pir_Status=0;
}

if(Pir_Status || IR_Status == 1){
Alert_Status = 1;
// then send out alert to relay
// sensors have been triggered
}else{
Alert_Status = 0;
// no sensor actived no nothing
}
```
this just allows the atmega328 work out that sensors have been triggered.

it all works all and great
as if either of the sensors gets activated the alert status is activated that will in time link into the #17

but it has one issue and that is the fact on startup IR Data is all way at the around of value of 110
see [pastbin](https://pastebin.com/c0YugAxK) for full log. but in short, it starts at a low value and slowly fills up the array smooth before stabilizing.  further investigation will be conducted tomorrow.

OLLYDOTDEV, 2020-07-24:
So first off before I can fix the issue I must work out what is the cause of the issue. The issue was found by looking at the output of the variables that get utilize with averaging in the smooth.h file

the point where the error was found was here `  _average = _total / _numReadings;`  this line of code takes the total of the past
x reading and calculates the average value (hence the class name analogsmoothing)

So ways to counter this there was a handful of options considered.
1. change the values of assisted variables. In this case, the only variables that have an effect on the average value are  _total and _numReadings and editing these would brake the rest of the system there for this rules out this option,

2. fully rewrite the logic of the averaging system. the rest of the system is just fine so no need to remake the whole thing to just get this small part to work so I won't be using this.

3. wait for x time (eg 10sec ) worth of data to pass be for allowing the alert system to be activated. Yes is an option that can work but I reckon I can find a quicker more time-efficient method.

4. once x amount has values have pasted then allow alerts to be sent. I have decided to go with a variation of this sort of design.

OLLYDOTDEV, 2020-07-24:
my first attempt at this I thought I worked but with more testing, it found that it still had flaws within the code.
the approach I had to take was to wait until _ValuecCount was great then _StartSkip but the issue was that it still need to return some value so I set it to so with getting to the first value to takes it is most likely to work most of the time but the issue is that it doesn't handle any broader cases of say if the sensor starts off in an activated state.

``` C++
if(_ValuecCount < _StartSkip){

 Serial.print("Skipping start value number:");
 Serial.println(_ValuecCount);
 _ValuecCount++;
 // give temp output value of first reading
  return(_readings[0]);
}else{
  // return value of object
  return(_average);
  }
```

OLLYDOTDEV, 2020-07-24:
so do counter these border cases I need to change the point of intercept.
seeing that the intercepting at the point where data end I then started to investigate the other end the input within the main code.

so If I adapt the code I just used for this end of the system there is a good chance that I should have a working fix to 8 unreliable values.

``` C++
if(_ValuecCount < _StartSkip){
  IRsensor.Smooth(IR_OUT); // triggers method but doesnt assign output to variable
 Serial.print("Skipping start value number:");
 Serial.println(_ValuecCount);
 _ValuecCount++;
}else{
IR_DATA = IRsensor.Smooth(IR_OUT); // triggers method and assign output to variable
}
```
and just like that it work and is able to hand the external border case allow for a more robust [code ](https://github.com/OLLYDOTDEV/Project-Birdseye-DTX-2020/tree/d88c92e00936e25c83399982f6e3cbbbdfae73aa/CODE/TESTING/Full_Trigger_Test)and outcome

OLLYDOTDEV, 2020-07-26:
and with this complete, I need to work on is transmitting the signal to a relay so that pi zero knows that the alert status has been triggered on ROMS. this can be followed with #16

Closed 2020-07-26.

Thread 13 (2020-06-11):

PIR Sensor

OLLYDOTDEV, 2020-06-11:
As user
I need more than one forum of a sensor on ROMS as a backup for https://github.com/OLLYDOTDEV/Project-Birdseye-DTX-2020/issues/12
so I can be sure that the information protection system activates

OLLYDOTDEV, 2020-07-18:
PIR or passive infrared sensor
(note PIR do not work well in a hot environment where the ambient temperature is the same as people's **this is one of the limitations of the functionality)**
is a sensor that is used to detecting people.
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

for this project birdseye I have decided to go with the  HC-SR501
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

- it is great as it has a long Sensing range: Max 7 m.
- it does have an Adjustable delay before triggering but this will not be used as I will be doing this in software.
- Input voltage range from 4.5 to 5v which is great as that is with my ROMS operational voltage
- has an Angle Sensor around 100 degrees FOV

[specs from here](http://www.robotpark.com/PIR-Sensor-Human-Body-Detecting-Pyroelectric-HC-SR501)

the other competitor was the HC-SR505 it has a smaller range and in theory the same cone angle but in practice, it is greater.
see [here](https://youtu.be/0zgY5x9Zq3M?t=254)

added need header to ROMS pcb to allow for PIR sensor connection
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
here is my wire up for testing

the code for this can be found on Github [here](https://github.com/OLLYDOTDEV/Project-Birdseye-DTX-2020/blob/5be2671fa7324843ffc766366609b1a13894ef12/CODE/pir_test/pir_test.ino)

both of these sensor fall under what is called a 1x1 pixel. as in short how they work are they take the average ambient infrared input and then checking if there has been a change in temp in the same place. with the sensor that has only one LARGE pixel you can get more pixel 4x4 8x8 16x16 etc that in turn allows you to see images and make out objects but there have been much research done and it has can be seen that in very few cases are the extra pixels properly utilized or give any additional reliability, therefore, they were not considered as a sensor for this project. as typically they more commonly used as bad thermal cameras (high pixel count)

OLLYDOTDEV, 2020-07-18:
now to move on to getting the two to work together

Closed 2020-07-18.

Thread 14 (2020-06-11):

IR Sensor

OLLYDOTDEV, 2020-06-11:
From an engineering view
This will be using the main sensor as a tripwire and well to detect movent within a room
So it will trigger the alert system protecting the private information

OLLYDOTDEV, 2020-06-25:
The obvious choices for me to use for an is a [TCRT5000 based sensor ](
https://www.banggood.com/TCRT5000-E2A3-1-Channel-Smart-Car-Infrared-Tracking-Sensor-Detection-PIR-Sensor-Module-p-1342386.html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
) or  [LM393 IR sensor](https://www.aliexpress.com/item/32321307168.html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,searchweb201602_,searchweb201603_ )

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
[TCRT5000 based sensor]
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
[LM393 based]

I happen to already have a hand full of both of these
tonight I will test what sensor will be better suited to this project as then I will have access to the hardware

OLLYDOTDEV, 2020-06-25:
There is one major difference between both of these sensors it is that the LM393 based sensor happens also output an analog output signal with the fact that sensitivity of the receiving diode is controlled by the potentiometer, in this case, I am able to get the IR sensor at having a max trigger range of a roundabout 0 to 12 cm see [here (video)](https://youtu.be/EXImOV3bThU) for demo

whereas the  TCRT5000  based sensor would still work the purpose of the sensor of detecting if a door had opened/closed but with a smaller max and would in turn decrease some of the situations that ROMS could be useful in. [demo (video)](https://youtu.be/13B7tXujcKg)

The videos in the paragraphs above this will give you a quick idea of what is happening with the sensors and the prototype/test setup I am using in short to recap. I am using the LM393 IR based sensor over the  TCRT5000 based IR sensor due to the fact that it uses an LM393 (low voltage comparator) combined with a potentiometer (variable resistor) that allows to fine turn the output of the IR sensor.
As a start, I pulled together some code that will read the value of the A0 pin
```
int IRSensor = A0; // connect ir sensor to arduino pin 2
void setup()
{
  Serial.begin(115200);
  while (!Serial) {
    ; // wait for serial port to connect. Needed for Native USB only
  }
  pinMode (IRSensor, INPUT); // sensor pin INPUT
}
void loop()
{
   Serial.println(analogRead (IRSensor));
 delay(100);
}
```

So as for a start, it showed a value of about 1020.
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

The value 1020 is the same as saying 5v
Here is what I it looks like when zooming in on that 5 volts
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

It can be seen that there is a value inconsistency of +-1
this should be kept in mind for later when making this more accurate.

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
There is what happens when I trigger the IR sensor by putting an object in front of it right now it has a max distance of 3cm so any time you put an object within the max distance it will trigger as seen in the image above.

 This is great but I want to see If it is possible to get more performance out of my hardware, in this case, to increase the max distance from 3cm to some great value. There is only one thing I am able to change on the PCB

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
(credit for image goes to [henrysbench](http://henrysbench.capnfatz.com/henrys-bench/arduino-sensors-and-input/arduino-ir-obstacle-sensor-tutorial-and-manual/))
Potentiometer so happened to control the distance that the  LM393 IR sensor activates

so for trying out all the values that this
there a small handful with some interesting properties

First is with the potentiometer all the way anticlockwise I get a pretty much-fixed output of 1020
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

the next is when the comparator is a value so low that the led turn on (this LED indicates whether the digital 1 or 0) so with all the online tutorials using a digital read this is as far they would be able to see as past this point but I have opted to use an analog read meaning that this LED is deceptive in reality should be ignored

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
here is the potentiometer to fully to the clockwise direction which is supposed to be most sensitive but this is not so.
as much as it is at the increased it is from the base distance in fact in yields a total of about 7 cm.

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

but there is the most interesting thing is when I orientate the potentiometer so it is not quite a digital one but almost it spazzes out. frantically jumps between the 1000 value and the 500 value

so I was like this is odd so I did some more testing of the distance it had increased to a massive 32cm activation distance, that is over 10 times total improvement.

having this great range significantly opens up more possibilities for different mounting positions and locations for keeping an eye on entry/exit doors.

OLLYDOTDEV, 2020-06-29:
This is sensor will be mounted on #20 rather than directly to the ROMS PCB this will be done via in internal headers
All that is need to hook up of the IR sensor is rather easy as it only uses three pins

VCC = 5V POWER
GND = Gound
OUT = Data out

the data out is that we care most about as this is what gives us the sensor data values
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
I added pins for it to be connected via a ribbon cable

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
the header pin for IR_OUT goes to Arduino pin A3 (hardware PC3)
I picked A3 as it is an analog pin rather than digital pins. the advantage of using an analog pin is coved in this [comment](https://github.com/OLLYDOTDEV/Project-Birdseye-DTX-2020/issues/14#issuecomment-649520131)

GIT[added header pins for IR Sensor](https://github.com/OLLYDOTDEV/Project-Birdseye-DTX-2020/commit/70c133b56a30cd2e045e3657a0f22720bb4f0e15)

see #12 for the full programming development

Closed 2020-06-29.

Thread 16 (2020-06-12):

Transceiver

OLLYDOTDEV, 2020-06-12:
As a User
I will be needing to have the capability to be used remotely way from my computer
As it much increases the versatility/flexibility and allows a more preventive approach of privacy.

OLLYDOTDEV, 2020-07-27:
Wireless communication is one of the many things that makes the whole project posable. Having a ROMS is a non-local location that allows ROMS to be Preemptive in the calculation to the time till the "threat" becomes an issue.

Wireless communication is all based on EMF waves but this isn't physics so I won't go into more depth on how they work but rather cover what option I have for Wireless communication.

OLLYDOTDEV, 2020-07-27:
the classic 433 transmitter and receiver.
Pro's
- cheep
- has high penetration due to being a reality low frequency
-

Con's
- low bandwidth
- short-range

OLLYDOTDEV, 2020-07-27:
NRF24

Pro's

Con's

OLLYDOTDEV, 2020-07-27:
HC12

Pro's
- works with 3.2 - 5.5v power
- uses serial communication to talk with the controller so nice and easy to use
- no extra library needed to use

Con's
-  You have to use 'AT' commands  to control

OLLYDOTDEV, 2020-07-27:
LoRa

Pro's
- robust
- low power
- super long-range (6Km)
- uses duel band of 443Mhz or also 1960Mhz
-  Is a newer type of hardware
Con's
- Uses SPA commutation but needs a total of 11 pins to use in total
- uses 3.3v
- needs a library to work

OLLYDOTDEV, 2020-07-28:
HC06 Bluetooth module

Pro's
-  use just to pins to control
- works with both 3.3v and 5v
- transceiver
- can be connected with smartphones

Con's
-  range about 10m
-  "At" commands to configure

OLLYDOTDEV, 2020-07-28:
So these are the some RF radios that are used. So to work out what one I am going to use I need to look and see if there is any large issues with any that straight out rules them out from being considered.

classic 433mhz RF transmitters and receiver is the first module that I can see that could be an issue.

1.   the fact that they have not a transceiver meaning that I would need to have two pairs of modules

OLLYDOTDEV, 2020-07-28:
So these are the some RF radios that are used. So to work out what one I am going to use I need to look and see if there is any large issues with any that straight out rules them out from being considered.

classic 433mhz RF transmitters and receiver is the first module that I can see that could be an issue.

1.   the fact that they have not a transceiver meaning that I would need to have two pairs of modules and that would start to take up a lot of internal room thus taking if off my list

HC06 Bluetooth module

All in all a great module but Bluetooth

1. It can lose connection in certain conditions like walls as it tends to use low wattage antenna.
2. It has low bandwidth as compared to Wi-Fi.
3. It allows only short-range communication between devices.
4. Security is weak as it can be hacked with ease.

LoRa

while it has to be one of the promising and interesting to knowledge is out there but due to
1. there is the issue that I have have the amount of free pins free thus ruling out this option

OLLYDOTDEV, 2020-07-30:
I have chosen to use the NRF24 as it just seems to fit my needs best and also what I had accessible on the cheap. so the first issue I needed to fix was getting a 3.3 power #11

with this, I then tested the theory of the voltage divider on a breadboard.
is I didn't have the right Resistors to I had to add some in serials that way the total Ohms was added.

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

In short, I have a 5v input from USB that then this volage goes orange oval we can se a 2.2 Ohms Resistor

OLLYDOTDEV, 2020-07-30:
next is to work out what pins I will need to uses that way I can then added it the ROMS schematic for the PCB

https://www.instructables.com/id/NRF24L01-With-ATtiny85-3-Pins/

https://components101.com/wireless/nrf24l01-pinout-features-datasheet

https://howtomechatronics.com/tutorials/arduino/arduino-wireless-communication-nrf24l01-tutorial/

these are the places for my guide to hooking up the NRF24

OLLYDOTDEV, 2020-08-05:
now while I do have the NRF24 connected to the SPI interface and while I can just upload the .INO file from https://github.com/nRF24/RF24

but when it comes to using this library on the raspberry pi zero w I was having issues
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

thus putting this sprint 5 to a halt as so further continue the user need the raspberry pi zero w set up so that they are able to have a remote control for the ROMS

OLLYDOTDEV, 2020-08-07:
to See more of the software look at #17

OLLYDOTDEV, 2020-08-14:
well while I was going to hookuping  the NRF24 to the raspberry pi I worked out that I needed some way to connected so for that i will be on #25. while working i had some large let backs

OLLYDOTDEV, 2020-08-16:
there is the pinout for the NRF24 is
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
and there is the pin out of the RPI zero (the w version has the same layout.)
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

so all that I need to do is connect them up and together via the dragram shown below from [tmrh20](http://tmrh20.github.io/RF24/RPi.html).
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

with that done I am left with

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

OLLYDOTDEV, 2020-08-16:
with this the hardware side of the Transceiver is complete

Closed 2020-08-16.

Thread 17 (2020-06-12):

Wireless Communication Subsystem Development

OLLYDOTDEV, 2020-06-12:
As an engineer
To utilize the transceivers within ROMS I need software that will link the radios
So that data can be transferred allow ROMS to communicate with the Central local relay

OLLYDOTDEV, 2020-08-09:
with the #24 set up
the #16 will next be startup then I can make a start on the code

OLLYDOTDEV, 2020-08-16:
#24 cover most of the setup but in short

http://tmrh20.github.io/RF24/Linux.html
http://tmrh20.github.io/RF24/RPi.html

cover what needs to be for setting everything. again the only issue I had was due to the face what I am using kali Linux I did not have stubs-hard so for the easy of me and other people trying to replicate a similar project I have made a [fork ](https://github.com/OLLYDOTDEV/RF24)with a reminder of what do if you encounter this issue as it was not documented anywhere on the web and had to be directly inquired with the head developer of this repository

OLLYDOTDEV, 2020-08-16:
as for testing the connection made in this [user story](https://github.com/OLLYDOTDEV/Project-Birdseye-DTX-2020/issues/16#issuecomment-674485403)

all that I needed to do from here was to make sure the radio object instructor was being given the correct CE and CSN pins number and that they match with the hardware layout given in

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

with that, I was ready to test.

upload to youtube my test video.

with all of this working how I wanted it to I am now about to continue with further development of the code

OLLYDOTDEV, 2020-08-17:
while I may now be able to control the NRF24 I how need to consider the flow of information for this, I can check my flow chart seen here.
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
(From Components and relationships sheet)

from here we can see that there is two mainstream of data that are being transferred. the first data stream is the mode that the ROMS should be in. (RPI --> ROMS) and the other steam of stat would be the alert status coming from the (ROMS --> RPI)
now it so happens the NRFT24 is only half-duplex meaning that it can only transmit or received data but not at the same time and has to switch modes. whereas a radio with full-duplex is able to transmit and received at the same time. see image to a visual explanation.

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
[ref](https://www.black-box.de/en-de/page/25078/Resources/Technical-Resources/Black-Box-Explains/Fibre-Optic-Cable/simplex-vs-duplex-fiber-patch-cable)

OLLYDOTDEV, 2020-08-17:
https://lastminuteengineers.com/nrf24l01-arduino-wireless-communication/

give a good wire up on now the inner workings the nRF24L01 module works when It comes to the duplexing system.

so with both streams of data identified I now will work on the logic that driver when what radios know what and when to send and receive

OLLYDOTDEV, 2020-08-18:
so really all that needs doing is to close the gap. This to consider when writing this code is for this is.

- that the radios I am using are only half-duplex
- try and keep power usage to a minimum

OLLYDOTDEV, 2020-08-18:
```
Setup
#------
import NRFT24 LIbrary
the set default mode to RX
initialize radio object
let channels and adders
#------
#TX
if input needs to be sent
set radio to TX
take input and formate it so that it is ready to send.
write to FIFO (First In, First Out) buffer
wait till FIFO butter is empty
reset to RX mode so that it is ready to received data

#------
#RX
loop (
check if radio free
listen to radio
pass data from radio data to variable
)
```

______________________________________________________

this would be the core of the transmission

on the ROMS and RPI, there would get in place some logic extra logic #29 to hand the data input/output of this Communication Network.

OLLYDOTDEV, 2020-08-26:
to here after a week of debugging and coding, I think I have found out have a way for me to make a Virtual serial link.
how it works is explained in the comment above

see here for code
https://github.com/OLLYDOTDEV/Project-Birdseye-DTX-2020/commit/b3fb46a5d136f45c1329921d71ef1e2286163eb6

OLLYDOTDEV, 2020-08-27:
so i broke it down to smaller core components BULK_SEND.INO and BULK_READ.ino
upload a youtube video of showing testing

OLLYDOTDEV, 2020-08-29:
Sending was not to hard do all that is needed for a simple send function is `radio.writeFast(&wireless_send, 4)`
and it will find the location of the wireless_send array in memory and then transmit the next four bytes.

but is has the issue that the packet was not successfully received it is unable to tell and this leads us to out End-user considerations as if for some reason if the packet was not received it could result in the alert sub system not being sent off and in turn alert subsystem isn't sent off when needed then it would result in the whole point of this project being irrelevant

OLLYDOTDEV, 2020-08-29:
to work that's the packet was received intact we can use a CRC, in short CRC is just a checksum (cryptographic hash function that will always give the same output if the same input is given) is used to check if the packet is fully received
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 (Checksum image from Wikipedia)
Both Nodes already have the checksum function and all that happens is when the input of the received data in contrast to the checksum of the received data if the checksums match then the data was received successfully.
these principles are implemented into nRF24L01+, it also uses the Enhanced shockburst mode for send RF data thus allowing to to have these more complicated methods of validation compared to the traditional regular nrf24 packet.
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
(image from http://yveaux.blogspot.com/2014/07/nrf24l01-sniffer-part-1.html)

but so far I have only shown how I will be using checksums but that by itself is not enough to reliably determine whether the transmission was received. there is where the acknowledgment (ACK) subroutine come into use.

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

this gives a valid demonstration on how to secure a reliable connection between NRF24 radios
[youtube.com](https://www.youtube.com/watch?v=a2FBa4MK66M)

OLLYDOTDEV, 2020-08-29:
there i have [added ACK](https://github.com/OLLYDOTDEV/Project-Birdseye-DTX-2020/blob/6678855e99da969ebb7a41ee4c20273cb42c68bf/CODE/TESTING/NRF24/Wireless_Communication_NRFT24_Test/Wireless_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) capabilities to my transmission code as well as smooth out another bug I was having after a successful transmission of a still continue to transmit rather than defaulting back to receive mode. This issue is caused by some incorrect logic within the an if statement that controlled when to change the mode back to RX(received).

OLLYDOTDEV, 2020-08-29:
With this we can see that if I give the device a packet to send I will automatically switch into TX mode then transmit the packet and looking ACK packet and to then switch back into RX mode if it did get confirmation that the packet was received successfully if it does not receive an act packet able continue to retransmit until it gets a reply.(while it is still waiting for a ACK packet I puts it in a queue that then get cycled through of tasks for the microprocessor to complete.)
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

OLLYDOTDEV, 2020-08-29:
Having it automatically switch into TX mode is great but there is a rare board case that both nodes set them self both to TX mode due to both trying to transmit at the same time no packets will be received and they will stay in the transmit mode infinitely. now, this is a bit of an issue. here is that the  printed out when both ended up in transmit mode

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

OLLYDOTDEV, 2020-08-29:
There are two ways to fix this in my mind.

1. using[ txStandBy();](https://tmrh20.github.io/RF24/classRF24.html#a12cc453453c94969d4d3f0edb3778c83)
2. using a timer to see if there has been x amount of failed transmissions

after some testing of plausible approaches both methods, I've come up the third method
3. this uses  [`txStandBy(time);`](https://tmrh20.github.io/RF24/classRF24.html#ab7f54decbe9d06cb026a5d3dfb505116) to  Number of milliseconds to retry failed payloads then if it still fails after that I all ready know that is had been failing for X ms so I then will all the RXF() function (this function changes the mode receive) and after 5 seconds looking if another radio is sending then  Return to trying to send the last message

OLLYDOTDEV, 2020-08-31:
well turn out that using `txStandBy(time)` in this manner would be an incorrect uses of this function, but for while trying to get this function to work that I had managed to create the logic need for it anyway fortunately I found a way to reuse it
```C++
 if(0==radio.txStandBy() ){ // keeps trying to send data for 5 seconds
        Serial.println("Unable to Transmit ");
        Serial.println("Checking to other Radio is Transmitting ");
         RXF(); // change to

         while(receiving == true){
         Serial.println("other radio transmitting waiting for available transmission slot");
         RECEIVE();
         }
 
         TXF();
         receiving = false;
       }
     }else{
     Serial.println("Transmission Successful\n");
     UnsentData == false;
     }
```

OLLYDOTDEV, 2020-08-31:
so while this might not be the desired outcome of this operation of the transmission system in the development of the radio drop out sub-system there was another idea that some to mind. a fourth option that could be used in place of the logic to control this sub system. I can use the system of keeping track of the time spent  trying to transmit, this by its self will work but to ensure that this reserve subsystem does not accidentally engage to do this I will also be checking if the amount of fails transmitters is at x amount

OLLYDOTDEV, 2020-08-31:
https://github.com/OLLYDOTDEV/Project-Birdseye-DTX-2020/commit/7c9ae55017f3311ce2f69ba2962192cacbc47956

OLLYDOTDEV, 2020-08-31:
next of to allow it the Wireless network to dynamically send input to data rather than pre-allocated payloads

OLLYDOTDEV, 2020-09-01:
for this Typedef and Structures Combined and key C++ alias naming function

[norwegiancreations](https://www.norwegiancreations.com/2017/10/getting-started-with-programming-part-8-typedef-and-structs/)

and example of this being [implemention](https://github.com/SensorsIot/NRF24L01-Bi-Directional-Communication/blob/master/NRF24L01-Bi-Directional-Communication.ino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) on both NRF24 project from other electronic engineers.

so the first change that needs to be made is to allow for dynamic payloads. dynamic payloads for the radio is easy as `radio.enableDynamicPayloads() ; ` just needs to be called in the start-up.

OLLYDOTDEV, 2020-09-01:
as well so changing the fixed payload size . this  changed mygetting the payload size with `sizeof(wireless_receive
)`

OLLYDOTDEV, 2020-09-03:
dynamic payloads work fine but the Text I am trying to send happens to be in a string form and the NRF24 Radio Libray I am using happen to not support transmitting or receiving strings but rather only char, char arrays, int, Bytes

so I began seeing what form string can be converted into. the first thing that comes to might was converting into Bytes (raw binary)
but turn out, fortunately, strings can be converted to char array with relative ease
[why shown here](https://stackoverflow.com/questions/1287306/difference-between-string-and-char-types-in-c)

` DataPak.Data.toCharArray(RadioBuffPak.Buff,DataPak.Data.length());`

but that didn't work there Is like the likes of [`charAt()`](https://www.arduino.cc/reference/en/language/variables/data-types/string/functions/charat/) but I was unable to get that to work.

but what i was able to get to work was
` BuffPak.Data[i] = DataPak.Data[i]; `
      ^^^                            ^^^
 char array                    String

demo of this [code](https://github.com/OLLYDOTDEV/Project-Birdseye-DTX-2020/commit/4de99af05dcec151720f0b2abea2382f9368abc7) can be viewed here.

with all of this, I am able to send and received Strings by converting them to Char array then transmitting them and then converting them back to a String

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

OLLYDOTDEV, 2020-09-03:
As for char array to String  Conversion, it is  done by calling the C++ String Constructor in the formate ` String foo(char_array)`
as found in https://forum.arduino.cc/index.php?topic=519481.0 `String TempBuffString(BuffPak.Data)` is what iwas used in the code found https://github.com/OLLYDOTDEV/Project-Birdseye-DTX-2020/commit/6e22f91d8f08b35da6c1547a4a911b280b5df6fb

it should be noted that due to Typedef and Structures Combined you cant just directly declare the char array into it but rather have to set another temp String equal to the char array then make the temp String = the string you want to equal the array

[    `String TempBuffString(BuffPak.Data);       DataPak.Data = TempBuffString;`](https://github.com/OLLYDOTDEV/Project-Birdseye-DTX-2020/blob/6e22f91d8f08b35da6c1547a4a911b280b5df6fb/CODE/TESTING/NRF24/BULK_READ/BULK_READ.ino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)

OLLYDOTDEV, 2020-09-03:
note while testing the  receiving data will always be 32 bytes as that is the size of the char array

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

OLLYDOTDEV, 2020-09-05:
the last check that needed to be implemented was to check if the packet meets the necessary conditions to be able to send via the nrf24 radio.

There are two checking key points that need to be checked

1. when converting the String into the char array buff to make sure that the string it not larger then the array this is done with
[`if(Wireless_Send.Data.length() <= sizeof(Buff_Send.Data)){`
](https://github.com/OLLYDOTDEV/Project-Birdseye-DTX-2020/blob/68636b283d7af70ad46cdaba533535275ca9e824/CODE/TESTING/NRF24/Communication_NRF24_Test/functions.ino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) With this I am able to stop the prevent overloading Char array with to large-sized string

2.  also to stop data loss it is checked if the Buffer that the radio is going to send is smaller then the max amount of byte the radio can send

[`if(sizeof(Buff_Send)> 32){`](https://github.com/OLLYDOTDEV/Project-Birdseye-DTX-2020/blob/68636b283d7af70ad46cdaba533535275ca9e824/CODE/TESTING/NRF24/Communication_NRF24_Test/functions.ino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)

OLLYDOTDEV, 2020-09-05:
With this the network is fully working but in the microprocessor side of the code.
it now needs to be Compiled into raw C++  this will be covered in #30

Closed 2020-09-05.

Thread 18 (2020-06-13):

IO

OLLYDOTDEV, 2020-06-13:
As a developer
For ROMS it needs a to have IO ports
To allow uploading of new Skechers and for debugging or to be later used as a means to provide power.

OLLYDOTDEV, 2020-09-23:
never left prototype stage from the breadboard combined with the project running out of time the it'll be no longer developed

Closed 2020-09-24.

Thread 19 (2020-06-13):

PCB

OLLYDOTDEV, 2020-06-13:
As an engineer
I need a platform to connect all of the components of ROMS to make a coherent circuit / electrically connecting the components it also gives mechanical support
otherwise, without ROMS with just be a pile of components sitting there unable to perform the desired function.

OLLYDOTDEV, 2020-09-23:
never left prototype stage from the breadboard combined with the project running out of time then it'll be no longer developed

Closed 2020-09-23.

Thread 20 (2020-06-13):

Case

OLLYDOTDEV, 2020-06-13:
As a user
ROMS must offer protection from external factors and therefore relatively robust in the fact that you should be at chuck in your backpack. while also being lightweight and easy on the eyes aesthetically
so people don't need to worry physically on them and also make it look less conspicuous

OLLYDOTDEV, 2020-09-23:
never left prototype stage from the breadboard combined with the project running out of time it'll be no longer developed

Closed 2020-09-23.

Thread 21 (2020-07-26):

p4wnp1 aloa cli

OLLYDOTDEV, 2020-07-26:
As a programmer
I will be using p4wnp1 aloa on s PI Zero to custom HID scrips to control the PC with web config
thus allowing the computer to be controlled by the PI zero.

OLLYDOTDEV, 2020-09-22:
with the #22 hid scripts made and located in [HID Folder](https://github.com/OLLYDOTDEV/Project-Birdseye-DTX-2020/tree/9e0ffa937c8439cfab3cb83f3057e866924911cc/CODE/Release/HID). they now needed to be executed when
this was done with`system("my_bash_script.sh");` <--- some hid script

but an issue is that the way that `ROMS` is setup is that it will transmit everyone that when it polls the sensor and they are triggered that will transmit "alert" but does not way when setup to say there it is no longer trigger. there for `ROMS` sends a lot of `Active` packets and since the HID runs everyone a `Active` packet is received in depending on the hid script that is currently enabled the second activation does the inverse for the First. So if the  The First One hides everything by minimising all windows, the second the `HID` script activates it might do the  inverse and maximiser windows... and repeat

there are two ways to fix this

1. every time that `active` alert packet is received to start a countdown timer and while that count down is active don't let the HID script reactivate.

2. add a sending function to the `ROMS` code that also says then the sensors are no longer trigger and then not allow the HID script to retrigger until it received that it is no longer triggered.

i will be going with number 2 as the data status verification method as it would be more reliable due to the fact that it is using  software flags to confirm whether the situation is active or not rathener rather than just taking a guess after X amount of time.

OLLYDOTDEV, 2020-09-22:
with reliability in mind as with the Functionality, in short of error unacceptable, It must  work flawlessly therefor I have two systems in placed to stop a double activation of the HID script

The first one takes place on `ROMS` and what it does is restricted the transmissions to only when there is a change in the state. EG ACTIVE -> OFF vice versa. this us using the `JustTransmitted ` Boolean variable as a software flag for whether there has been a Transmission. https://github.com/OLLYDOTDEV/Project-Birdseye-DTX-2020/commit/d8302ae81ce4393c5c6dca7c2b27b443e9e8a8de this also happen to speed up the overall total loop processing time which is a plus which allows more operations per second

and the second one is that takes place on `RPI`

this worked my added `if()` statements to the `AlertStatus` function.

the first one checks if `HID_Active` is true and if so prevents the HID script from being run again.
the next if statement resets the `HID_Active` bool value to false when once a `Alert` packet with the data of `OFF` has been Received
then the last if statement only runs if `HID_Active` is set to false and data of `ACTIVE` has been Received

https://github.com/OLLYDOTDEV/Project-Birdseye-DTX-2020/commit/096533e3d764d00b581fdc96a614e52882d37ae4

OLLYDOTDEV, 2020-09-22:
To improve the user user experience we can see that for the HID portion of this system is lacking when it comes to [Usability Heuristics](https://www.nngroup.com/articles/ten-usability-heuristics/) as for now there is no way of seeing what HID script is active due to a lack of visibility of system status. there is also a issue of User control and freedom as if the end user wants to chance what HID script will be active then it needs to recompile the `RPI.cpp` and that takes time, there Projectbirdeye is out of the box working solution.

To fix the lack of visibility for the system status the active hid script will be displayed on the web interface in addion the web interface will be able to control what HID script will be actived as well as the addion of new scripts

OLLYDOTDEV, 2020-09-22:
So the start with the fix for `RPI.cpp` was to set it to execute from a constant file called  `Selected.sh`
and now to control the contents of `Selected.sh` this is where the changes to the web interface come in.

the first change is to do with the dynamic layout
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
Here every HID script is read from the folder and then the name displayed. (in progress is the adding of the contents to the `Selected.sh` ) this layout will added a new row once there is a total of 4 columns worth of cells.

each of these cell's will get gived a href (hyperlink) to HID.php but to be able to work out what link was clicked each link will have a hyperlink with a parameter of the name of the HID script to set at active. to get the parameters from the hyperlink with [$_GET](https://www.w3schools.com/php/php_superglobals_get.asp)

OLLYDOTDEV, 2020-09-23:
and just as expected changing my URL to `hid.php?active=ChromeNewTab.sh` when combined with
```  php
<html>
<body>
<?php
// https://www.w3schools.com/php/php_superglobals_get.asp
echo "INFO: " . $_GET['active'];
?>
</body>
</html>
```
we get the expected output of
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

OLLYDOTDEV, 2020-09-23:
with this site is used to
1. copy the selected `.sh` into `selected.sh` <-- this is that the `RPI` binary executes
2. set `selected.txt` to have the path of the active directory

OLLYDOTDEV, 2020-09-23:
the first error that was encountered was that the input PHP command` COPY()` was failing to do task 1
you as a alternative are used the native Linux `cp` in conJunction with php's ability to execute commands to run
```php
echo"<script>alert('$file. Set as Active HID Script');</script> ";
```

as for number 2
```php
$myfile = fopen("../HID/Selected.txt", "w") or die("Unable to open file!");
fwrite($myfile, $file);
fclose($myfile);
```
the allow the software to set permanent storage to be read later (by the control panel)
`chmod 747 *` in the one `HID` directory persistent value as otherwise it cant be written too.

OLLYDOTDEV, 2020-09-23:
the last key piece to add to the control panel is feedback to show what HID script is selected. this will a matter of reading from my persistent file that contains the filename of the Selected file.

todo this

```
$txtfile = fopen("../HID/Selected.txt", "r") or die("Unable to open file!");
echo "Selected: ";
echo fread($txtfile,filesize("../HID/Selected.txt"));
fclose($txtfile);
```
this reads the name of the scripts that will be executed when an ALERT it sent out.

as a final part of the functionality, uses can add custion HID Scripts via the web interface. Todo this some old code that i have used in other older project will be reused from [Abideyouth](https://github.com/OLLYDOTDEV/Abideyouth/blob/387757f1b4e26f3458ccadd33b0fd9f5b027cabb/FinalCode/ptable.xyz/gallery_uploading.php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
)

while i could just add a file upload form. because HTML form has no validation / sanitation they cant be trusted, infact if the information comes from the use it is best practice to always sanitise it and verify that it meets the expected requirements.

things that will be verified are the files

- fileSize
- file error (was there a error uploading it )
- fileType (the type of file to prevent unwanted types of files being uploaded)

OLLYDOTDEV, 2020-09-23:
while a html forms do provide these information they do nothing with the data and it can also be faked to the method of cross compearing check the information that the form gives to the data we can extract from the file.

Closed 2020-09-23.

Thread 22 (2020-07-26):

HID scripts

OLLYDOTDEV, 2020-07-26:
As a developer
I will need to use HID (human interface device) scrips emulate a keyboard to control the computer
So that #21 can utilize these scrips

OLLYDOTDEV, 2020-09-22:
Once I had connected the RPI to my test bench (my desktop) with a USB cable. this USB cable must be connected to the RPI zero w data USB **NOT** the power USB port.

then to test if there was an HID connection with my test bench
i used the example HID cli command found in the Repo [README.md](https://github.com/OLLYDOTDEV/P4wnP1_aloa)
`P4wnP1_cli hid run -c 'type("Hello world")'`
and just as expected it typed `Hello world`
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

the great thing about this is that due to the fact that is running of the bash command line I am able to put this to a bash script file (.sh) and these files can be run from `RPI.cpp`.

from here I can start making some more useful HID scripts

OLLYDOTDEV, 2020-09-22:
a function that is a simple but yet universally recognized in the short cut to the lock screen (Windows, Linux,
macOS)

So in the last hid script the `type` function was used which just directly takes the input in types it out
The other important function is the `press` function this allows the uses of modifier keys

The modifier keys are
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
https://github.com/OLLYDOTDEV/P4wnP1_aloa

with that, I can take that knowledge to make
`P4wnP1_cli hid run -c 'press("GUI l")'` and well this locks the screen on Linux and windows anyway, I don't have a mac to test on
but here is the[ test on my personal system
](https://youtu.be/dv48vM4iE6c)

OLLYDOTDEV, 2020-09-22:
added to the `HID` folder is also `desktop.sh`,`lock.sh`,`switch.sh` as some to suit some potentially common use cases infrastructures will be in place where end users can add their own custom hid. but with having HID scripts made, the next move it isn integrate them with the rest of the system as will be seen in #21

Closed 2020-09-22.

Thread 23 (2020-07-27):

Mode Input

OLLYDOTDEV, 2020-07-27:
As a user
I should be able to make a choice on what mode the ROMS is in. (the data for this will come from #29 )
so ROMS knonws how the data will be handled

OLLYDOTDEV, 2020-09-14:
talk about

what you tryed to get C++ to get user input via web interface

and why I settlated on using live phasing

OLLYDOTDEV, 2020-09-14:
with the aim here being to control the mode via a given input via a GUI(graphical user interface) . I needed to work out what was I going to use for the GUI. So over the past 4 days have consisted of test what forms of backend software can run on the RPI W running Kali Linux (arm6l).

The first option It tried to get working was a node.js. this would have been great as it non-blocking asynchronous back-end API but would have allowed direct integrating with my C++ but the RPI W is running on the ARMV6 RISC CPU architecture and when also combined with also using an older Linux kernel you are unable to install nodejs. (yes also in docker this was not able to be executed when using another distro )

the next option that research show was to host the server with C++
while this does work it is with frameworks like [Crow](https://github.com/ipkn/crow)[,µWebSockets](https://github.com/uNetworking/uWebSockets),[Mongoose](https://github.com/cesanta/mongoose),[Boost Beast ](https://www.boost.org/doc/libs/1_66_0/libs/beast/doc/html/beast/introduction.html), [cpprestsdk](https://github.com/microsoft/cpprestsdk)

while I tested most of them only having 512MB of ram restricted to already compiled binaries and well there are hard to come by and the only other option was to cross-compile them for ARM6L but due to this project being due in 2 weeks this is not sufficient time to set that up.

so that consider I was left with a basic web server, was one option to use the Nginx web server but for some reason, it was not able to find any files on the SD card.

In the End, Had to use the backup plan for when all else failed (because well that what happened) so for this pack up plan I am using is apache2 webserver. this at first didn't work when setup but after reinstalling it then worked just fine.

with the host working. I am next able to now write the code that will allow the user to interact via a web GUI.

the reason why it was decided to utilize a web interface was that most modern devices will be able to interface to control it  allowing for greater usability

OLLYDOTDEV, 2020-09-14:
for the frontend, it will HTML and maybe some CSS, as the aim it functionally with less focus on the Aesthetics
the backend will be run of PHP as being a  general-purpose scripting language it works well with the integration of C++ CLI with the UNIX Terminal. as it is able directly to call and execute files, again this helps with usability as it helps to show the system status and allow to more diverse usage. this is done with `shell_exec()` while this would run the code it wouldn't show the user(as it is a blocking function ) if anything has been/is running there for i am using to look for non blocking version of this command

OLLYDOTDEV, 2020-09-19:
while `shell_exec()` does call the function it is a blocking function. therefor It doesn't give an output till the end of the script has been reached, this is an issue as the code that needs to be executed is in a forever loop and therefore will never reach the end and inturn never give an output. so the alternatives are being considered as a nonblocking function.

options are

javascript using [`EventSource`](https://www.w3schools.com/html/tryit.asp?filename=tryhtml5_sse)

using [pcntl_fork](https://www.php.net/manual/en/function.pcntl-fork.php) this makes a child process PHP PDI

or the Linux command [at](https://www.computerhope.com/unix/uat.htm)

OLLYDOTDEV, 2020-09-19:
`sudo apt-get install at`

OLLYDOTDEV, 2020-09-19:
using `shell_exec('sudo /projects/Project-Birdseye-DTX-2020/CODE/Release/WebServer/commands/ALL.sh | at now 2>&1');`
calls a external bash script that first off kill any other scripts that would interfere with its functionality.
`timeout 5 sudo ps -ef | grep ./../RPI/RPI | grep -v grep | awk '{print $2}' | xargs kill`
then the compiled RPI.cpp is executed `sudo ./../RPI/RPI ALL`
 and with that code is being called from the web browser. but to make it more
flexible I will be implementing the use interface to the allow section of the different modes. this will consist of a simple gui

OLLYDOTDEV, 2020-09-20:
to allow the nonblocking operation for the front end. PHP-FPM had to be [setup ](https://www.cloudbooklet.com/how-to-install-php-fpm-with-apache-on-ubuntu-18-04-google-cloud/)

after that as talk about previously, the `command will be called on page load as this allows us to run code on a separate CPU processes allowing for a asynchronous command execution.  the commands that `at`  executes is read from a file stored in `/projects/Project-Birdseye-DTX-2020/CODE/Release/WebServer/commands/` this in has are a set of bash file that are then run to asynchronous run RPI software.

OLLYDOTDEV, 2020-09-20:
here in the `index.php`,
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
From here if you for example click on the ALL link then

the code from `all.php` is run

```
<?php
require('assets/Control.php');
Control();

echo shell_exec('sudo at now -f /projects/Project-Birdseye-DTX-2020/CODE/Release/WebServer/commands/all.sh ');

home();
?>
```

the page starts off by calling the `Control()` function this displays the Control panel

Next with `shell_exec()` called the `at` command to start running RPI asynchronously.
Then to end everything the `home()` function is called this used JavaScript to redirect the browser to the index page this server the purpose of updating the GUI to show run Processes.
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

Closed 2020-09-20.

Thread 24 (2020-08-05):

Linux distribution

OLLYDOTDEV, 2020-08-05:
As a developer
I need some sort of operating system to interface with the hardware and provide firmware.
this is so that the raspberry pi zero w can be used to its fullest potential of sweet features.

OLLYDOTDEV, 2020-08-05:
While I may be using a raspberry pi zero w I will not be using the traditional [noobs](https://www.raspberrypi.org/documentation/installation/noobs.md) or Raspberry pi OS. I have been open to other Linux arm based distros and when you consider the fact that the key part of the PI is to inject keystrokes into the computer #22

now inject keystrokes normally is used to in pentesting or malicious hacking so what better distro to use other than kali Linux as kali will have all the needed prerequisites

OLLYDOTDEV, 2020-08-05:
as a start I will not be using any old version of kali Linux but rather a custom version compiled by RoganDawes this has an added framework ` which turns a Raspberry Pi Zero W into a flexible, low-cost platform for pentesting, red teaming and physical engagements ... or into "A Little Offensive Appliance".` thus allow being to interface #22 HID scrips and more with this framework. (more on this framework with #21) the download for this ISO is found [here](https://github.com/RoganDawes/P4wnP1_aloa/releases/tag/v0.1.1-beta)

OLLYDOTDEV, 2020-08-05:
it was found in sprint 5 that #16 was having issues due to some missing dependencies that would have already been in place if I was using a more stock distro so what I need to find is  how to get these missing libraries onto my pi.

OLLYDOTDEV, 2020-08-06:
so for a start, I found that I needed to start off with enabling SPI
this is done with editing the /boot/config.txt and changing `dtparam=spi=off` to `dtparam=spi=on`
then rebooting then SPI is enabled

OLLYDOTDEV, 2020-08-06:
now down to the core of the issue is that I file is missing dependencies for the compiler. so the first thing to sort out was the fact that `arm-linux-gnueabi`  so I set that up using some of the comments from https://www.acmesystems.it/arm9_toolchain

but while it did get me
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

from here I can see that all I am missing is the stubs-hard.h
after a lot a googling I was unable to find how to obtain this file. that is when I started to think what if modify the  `Makefile.inc`
well after seeking help on the GitHub repo for the NRF24 library, I was pointed in the right direction on where I needed to start modifying the code  https://github.com/nRF24/RF24/issues/614#issuecomment-669635146.
with this in mind, I changed the code from requiring stubs-hard.h to stubs-soft.h. This is what stubs-hard is best explained by [googlesource](https://gfiber.googlesource.com/toolchains/mindspeed/+/f6153d9b5022adf0575515eaebc05c2a3b08c688/arm-buildroot-linux-gnueabi/sysroot/usr/include/gnu/stubs-soft.h )
[TLDR:](https://gcc.gnu.org/onlinedocs/gcc-4.4.7/gcc/ARM-Options.html) It is used for defining part of the architecture for Advanced RISC Machines (ARM)

with this, I then just need to tell the config file to use SPI
this is done by when you are in the `/projects/RF24-1.3.7` then you just run `./configure --driver=SPIDEV`
after that you can then use `make; sudo make install`  and it will compile and install the library in the Linux install as seen here on the GitHub [wiki](http://tmrh20.github.io/RF24/RPi.html) for this page.

and that should be all the setup needed for the Linux Distribution.

OLLYDOTDEV, 2020-08-06:
while that is all I had planned for this sprint the amount of research the had taken prior to this sprint is why this was able to run so quickly. So with this completed i can get back on working on #16

OLLYDOTDEV, 2020-09-21:
Note

it will try to connect to a AP as a station
ssid: Pi_Point
pw: Projectbirdeye

if a ap with those attributes cant be found it will switch into a fall back mode and host its down ssid for other nodes to connect to

when this project is deployed it is highly recommended that these settings are changed.
So to access the webserver it need to running in station mode not

Closed 2020-08-06.

Thread 25 (2020-08-05):

GPIO

OLLYDOTDEV, 2020-08-05:
As an electronic engineer
It is needed that a platform to interface hardware like sensor or Radio transmitters.
As there becomes a point in Project Birdseye that data must come from hardware into a full data processable form with 1&0 this GPIO is where that happends

OLLYDOTDEV, 2020-08-07:
for the SPI it needed to work out that was the interface it was connected to with the #16 so by using this command
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

how we can see that the

`/dev/spidev0.0` happen to aline up with spi0

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

that knowledge will be used in #16

otherwise, that is all that is needed for this sprint.

OLLYDOTDEV, 2020-08-14:
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

there see that I have tined the gold pads so that they are ready for soldering. then I tested to make sure that I hadn't shorted anything and it booted just fine.
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
(pi zero w with headers [link to image](https://learn.adafruit.com/introducing-the-raspberry-pi-zero/gpio-header-options) as I forgot to take an image of this stage)

so then I moved on to soldering headers but after I had to solder the header the Pi zero w wouldn't boot so I tried removed the solder and It still did not work.

OLLYDOTDEV, 2020-08-15:
So I thought that I had just got unlucky and shorted something when I powered while it was connected to the NRF24. so without looking to much further into in it I.

OLLYDOTDEV, 2020-08-15:
so with having my first Rasberry pi zero w not working I was lucky to have one on standing by as a backup. so again I tined the pads on the pi and it still worked just fine but this time rather the putting headers I directly solder 7 jumper wires as seen below

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

the pins I soldered to were 3.3v, MOSI, MISO, SCLK, CE0, GND,  GPIO 25 again it wouldn't boot so I when I started to worry no stores had any PI zero w in stock due to COVID-19.

Then I powered up the board after connecting the header (i had removed them my now to see if that fixed the issue )
and I here this https://youtu.be/H65ErzZNP3U so yeah not looking good.

so this time I got out my multimeter AND tested the continuity and I could see that the GND, 5v, and 3.3v were all shorted. Now I know that they weren't previously connected as a did of a test before it is any soldering thus mean something had shorted.

the first thing that comes to mind is my soldering on the GPIO pins, so using a microscope I inspected each pad individually on both sides. for examples of what I was looking at see the image below.

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

so keeping in mind that the width of one of those pads is about 1cm.

we can see that some of the surrounding solder mask is been burnt/scarped away with some excess solder at first I thought it might be shorting it to the GND plane but this can not be so as the ground plane is on layer 4. so might be still be shorting but I have evidence that might show there the issue is. now I repeated this process for all of the 7 pins that I soldered.

So my suspicions are that I could have damaged another component by heating it up too much.

OLLYDOTDEV, 2020-08-15:
so to work out that part was the issue. I leave the RPI Zero w plugged into 5v till stuff started to melt as seen here
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
charred parts is never a good sign.
the part that was generating the heat was the DC to DC converter
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

the odd thing is that this DC to DC converter to noware near where I was soldering thus meaning that it must come down to being overheader whiles soudering the headers i could have let the solder iron on the pad to long causing the PCB trancs to heat up and in the then the DC to DC converter.

OLLYDOTDEV, 2020-08-15:
This means that I now have two dead RPI Zero w's and with no shops selling it can am at a bit of a loss

so I have made three plans (in order of preference )

Plan A
Reach out to some contacts in the industry and hope that one of them as an RPI zero

Plan B
use my fall back plan and emulate HID with an ATMEGA32u4 instead of the RPI while it would get the job done it will limit the Functionalityof the project severely and this would hinder my interaction. the only main got'ya with this plan is that I would need to find an ATMEGA32u4 in NZ as from what I have seen is that they are few and far between seen being sold

Plan C
so failing to find any parts in NZ to buy to do have some parts I all ready have on hand that I would be able to DIY together.

Arduino pro mini

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

digispark attiny85
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

I would need to use the combined features of both to be able to complete this function of this project as having automatic HID input into the computer. These are the main features I need from each IC. From the Arduino pro mini, it would be using its SPI interface and it would be the master controller for the Relay, As for the attiny85, it is able to act as the USB HOST for a virtual USB 2.0 keyboard. yes, the attiny85 does have SPI for is lacking the Extra data pins to control the NRF24 as two USB of the three Digital IO pins.

OLLYDOTDEV, 2020-08-15:
I manage to find one more RPI zero w through contacts  that all ready has the header solder on meaning that i should have the same issues as last time
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

OLLYDOTDEV, 2020-08-16:
with this RPI zero the header this concludes all the work that needs to be on the GPIO

Closed 2020-08-16.

Thread 29 (2020-08-18):

Wireless data processing

OLLYDOTDEV, 2020-08-18:
As a software engineer
There needs to be some backend to take the data from #17 #30 and work out what to do with the given data packet. this will lead on to the mode selection found in #23
thus a conditional switching statement will be implemented to complete this story

OLLYDOTDEV, 2020-09-08:
pseudo-code for the sending function
```
function mode(role){

check role is a valued role

packet type = mode
data = role

call send packet function.
}

```

OLLYDOTDEV, 2020-09-08:
pseudo-code for the receiving

```
input packet
if (packet.type == role ){

switch(){

mode1
     call function to configure ROMS to mode 1
mode2
     call function to configure ROMS to mode 2
mode3
     call function to configure ROMS to mode 3
}
}
```

what each mode will do will be done in the next sprint and found in #23

OLLYDOTDEV, 2020-09-10:
https://github.com/OLLYDOTDEV/Project-Birdseye-DTX-2020/commit/08cfda5985f5be98dae3ead022404e1707a74b1c & https://github.com/OLLYDOTDEV/Project-Birdseye-DTX-2020/commit/a8e03e7c9562dfba7869de588345b6778b17c32f contains the implementation of Wireless data processing that is able to account for a range of border cases via using a wide range of different custom functions.

while some of these are the same functions as used in #30 they will have been modified to ensure reliability and validity.

such as `RECEIVE()` function updated to support the new data structure of the packets this structure houses the `Header` and `Data` that is processed using [non-trivial string manipulation](https://github.com/OLLYDOTDEV/Project-Birdseye-DTX-2020/issues/17#issuecomment-686260754) to allow it to be transmitted. as well as added a case switch.

the[ switch used ](https://github.com/OLLYDOTDEV/Project-Birdseye-DTX-2020/blob/a8e03e7c9562dfba7869de588345b6778b17c32f/CODE/Release/RPI/RPI.cpp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)in the `RECEIVE()` function within the `RPI.Cpp` file is using a whitelist system to check for incoming packets that have matching packet header properties of `MODE`,`STATUS`,`ALERT` if it doesn't match any of them then the packet is disregarded.

OLLYDOTDEV, 2020-09-10:
another function used/ changed is the `TRANSMIT(string header, string data )` this function is able to take two parameters. The header is used to see the header of the packet. this header is used to determine what should be done with the contents inside the packet, eg what mode ROMS should be in or just used to test the connection of the radios. these parameters are phased into char arrays before being formatted into a packet and then transmitted, for more on this process see [here ](https://github.com/OLLYDOTDEV/Project-Birdseye-DTX-2020/issues/17#issuecomment-686221963)

OLLYDOTDEV, 2020-09-11:
a  function added uniquely to  `RPI.cpp` is `void ModeInterface(void)`
this function is used to set up the packet that contains what mode ROMS should be in. as for now it is just set to a status value as that in will be added in #23

OLLYDOTDEV, 2020-09-11:
both will have in time the ` getstatus()` function and all that does I check if there is a connection between NRF24 radios.

OLLYDOTDEV, 2020-09-11:
lastly ROMS.ino a function added to it is `SecurityMode()` this function allows the data from a MODE packet to be deciphered into instructions. that can be converted into what mode ROMS should be running in.

OLLYDOTDEV, 2020-09-11:
for next stage of using this data after it has been processed see #23

Closed 2020-09-11.

Thread 30 (2020-09-05):

Wireless Communication Subsystem recompiled (RPI ZERO W)

OLLYDOTDEV, 2020-09-05:
as a software engineer
I have a [Wireless Communication Subsystem](#17) but so far that was compiled with C++, C, and java for it to run on atmega328p chips #2
now this as to be refined to just Raw c++ to that it can be Compiled with the GNU C++ Compiler for better knows as [`g++` ](https://gcc.gnu.org/onlinedocs/gcc/Invoking-G_002b_002b.html)
so that It can be also run in the RPI zero

OLLYDOTDEV, 2020-09-07:
https://github.com/nRF24/RF24/issues/622

Closed 2020-09-07.
