OLLYDOTDEV/Project-Birdseye-DTX-2020/Schematics/PCBS/LC_Board.sch

## EAGLE design Schematics/PCBS/LC_Board.sch (2020-06-22)

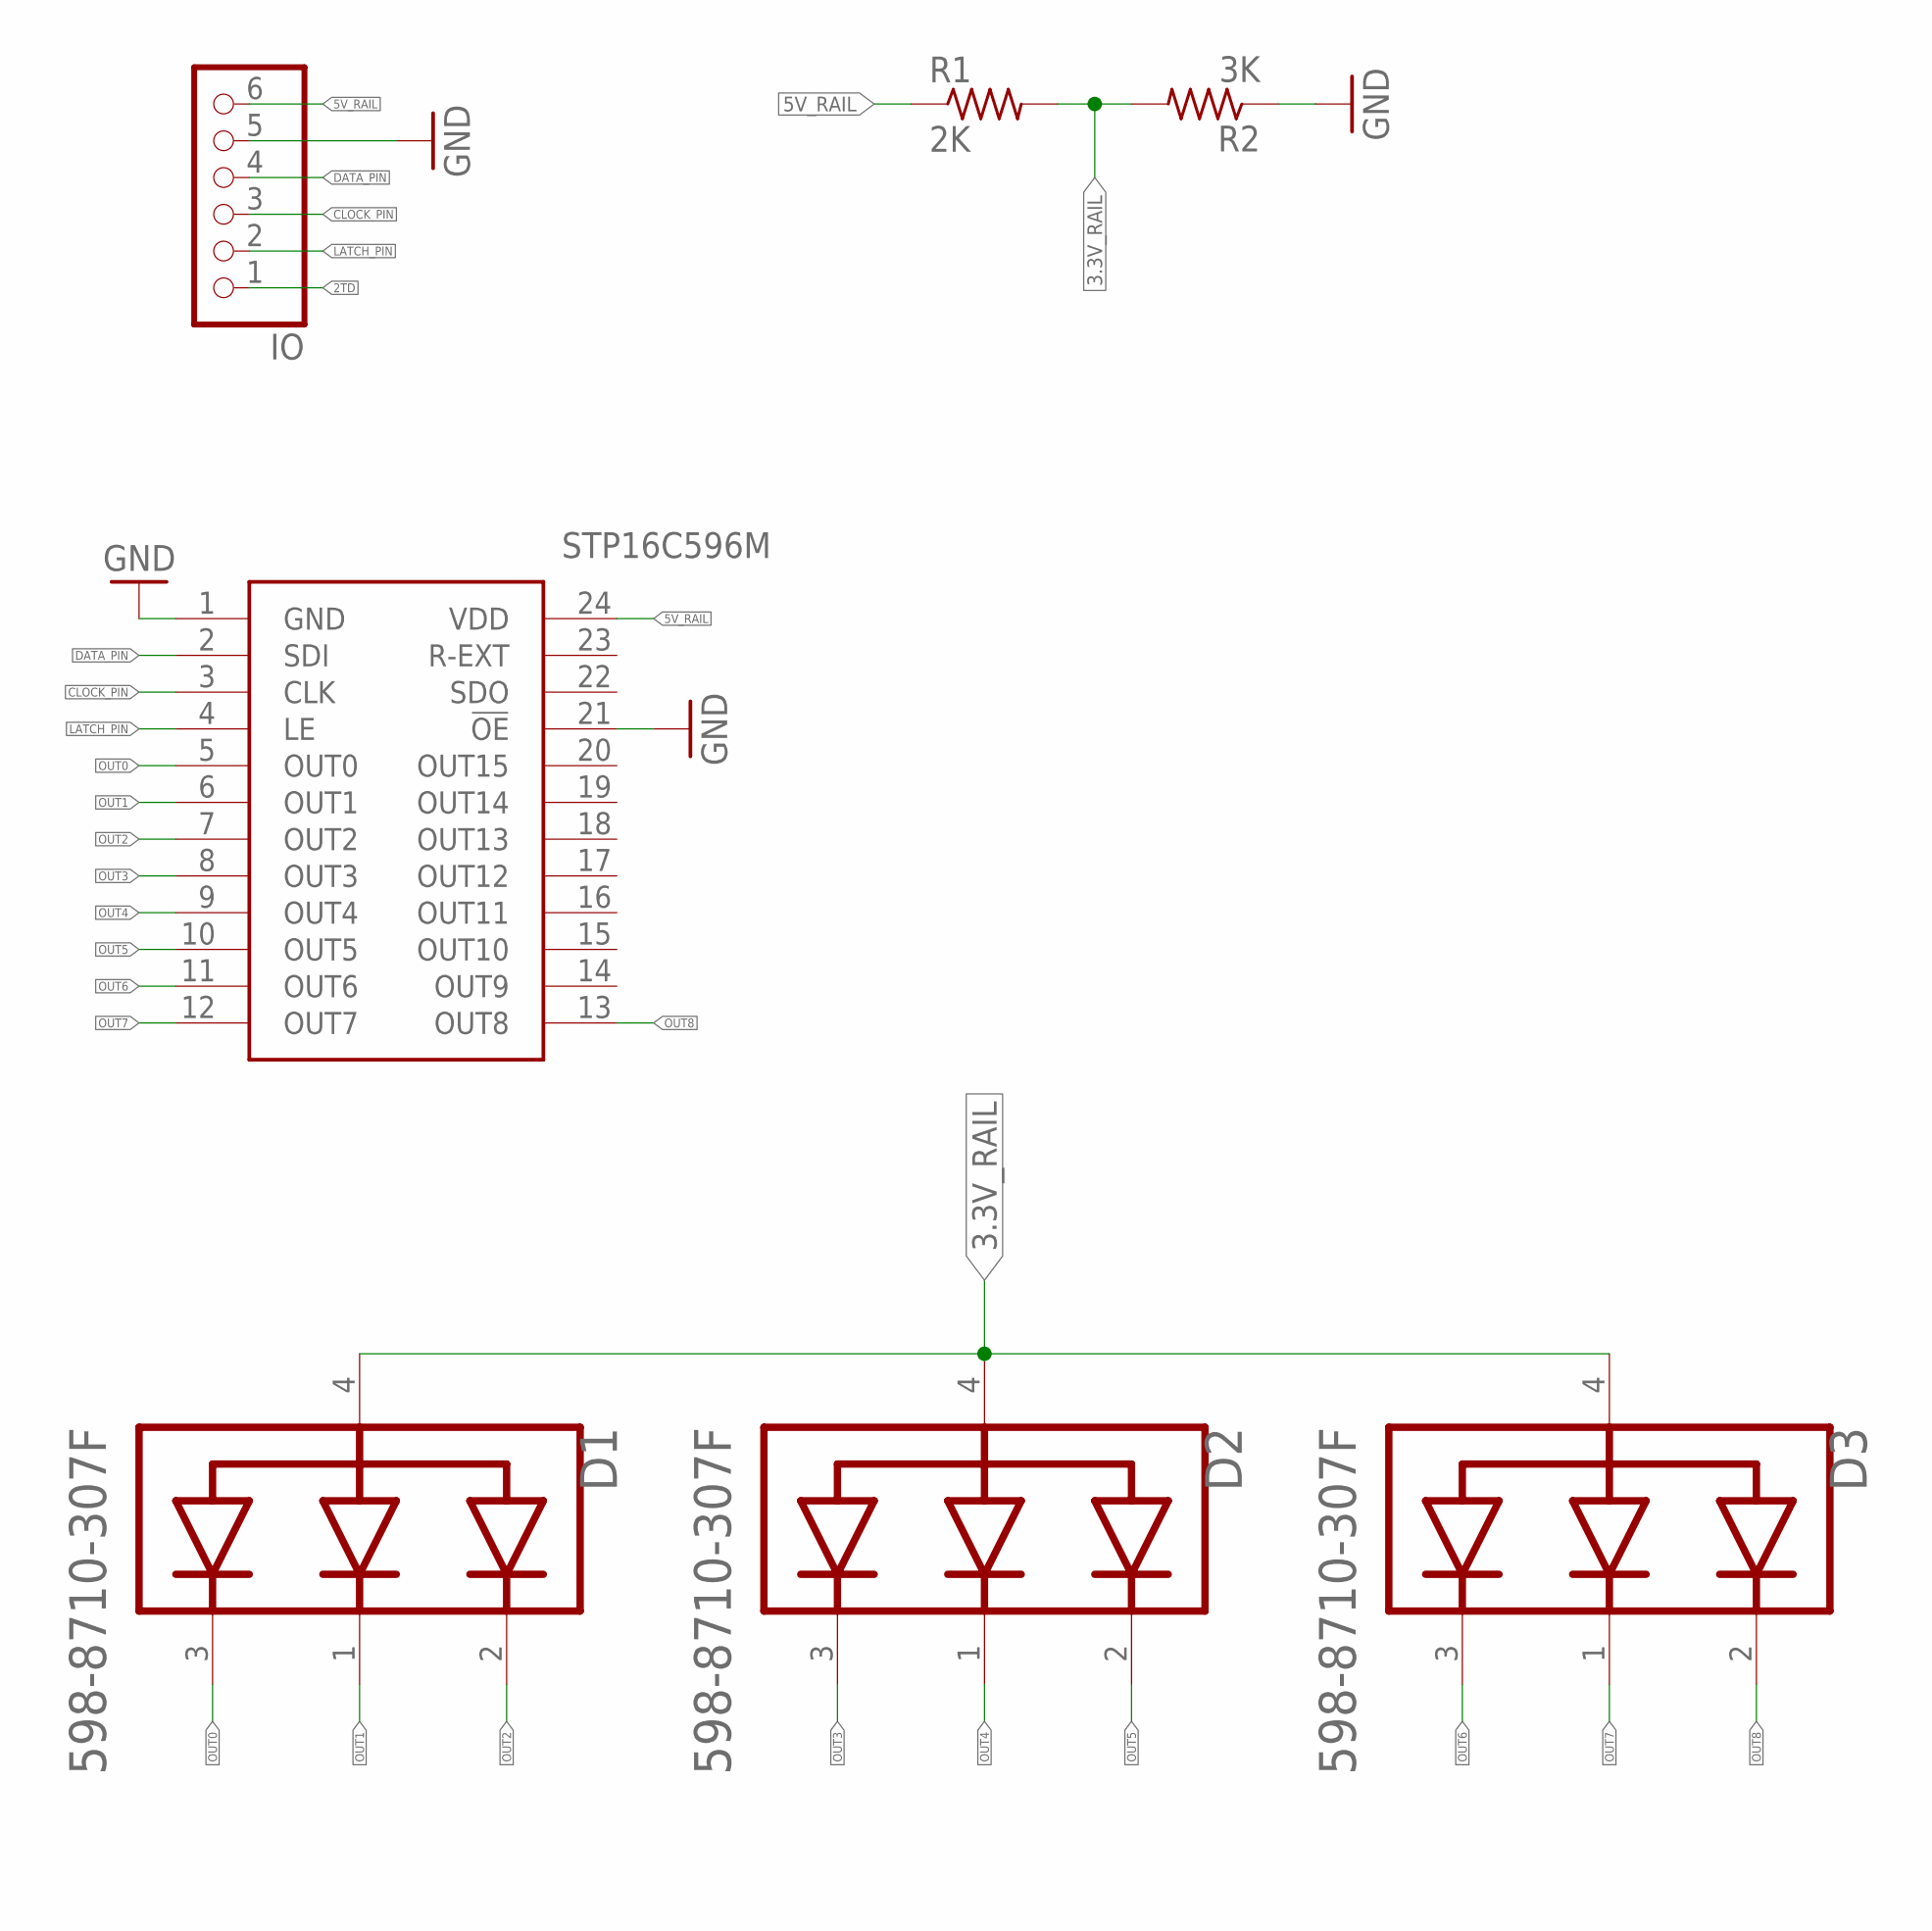
[picture p3: schematic LC_Board.sch]

Parts:
D1, D2, D3: DIALIGHT_598-8710-307FDIALIGHT_598-8710-307F_0_0; DIALIGHT_598-8710-307F_0
IC1: STP16C596M; SOP65P638X110-24N
IO: PINHD-1X6CLEAN; 1X06-CLEAN
R1: 2K; 0805-THM
R2: 3K; 0805-THM

Connections:
2TD: IO.1
3.3V_RAIL: D1.4 (COMMON_ANODE), D2.4 (COMMON_ANODE), D3.4 (COMMON_ANODE), R1.2, R2.2
5V_RAIL: IC1.24 (VDD), IO.6, R1.1
CLOCK_PIN: IC1.3 (CLK), IO.3
DATA_PIN: IC1.2 (SDI), IO.4
GND: IC1.1 (GND), IC1.21 (!OE), IO.5, R2.1
LATCH_PIN: IC1.4 (LE), IO.2
OUT0: D1.3 (BLUE_CATHODE), IC1.5 (OUT0)
OUT1: D1.1 (GREEN_CATHODE), IC1.6 (OUT1)
OUT2: D1.2 (RED_CATHODE), IC1.7 (OUT2)
OUT3: D2.3 (BLUE_CATHODE), IC1.8 (OUT3)
OUT4: D2.1 (GREEN_CATHODE), IC1.9 (OUT4)
OUT5: D2.2 (RED_CATHODE), IC1.10 (OUT5)
OUT6: D3.3 (BLUE_CATHODE), IC1.11 (OUT6)
OUT7: D3.1 (GREEN_CATHODE), IC1.12 (OUT7)
OUT8: D3.2 (RED_CATHODE), IC1.13 (OUT8)
