OLLYDOTDEV/Project-Birdseye-DTX-2020/Schematics/PCBS/LED's.sch

## EAGLE design Schematics/PCBS/LED's.sch (2020-02-21)

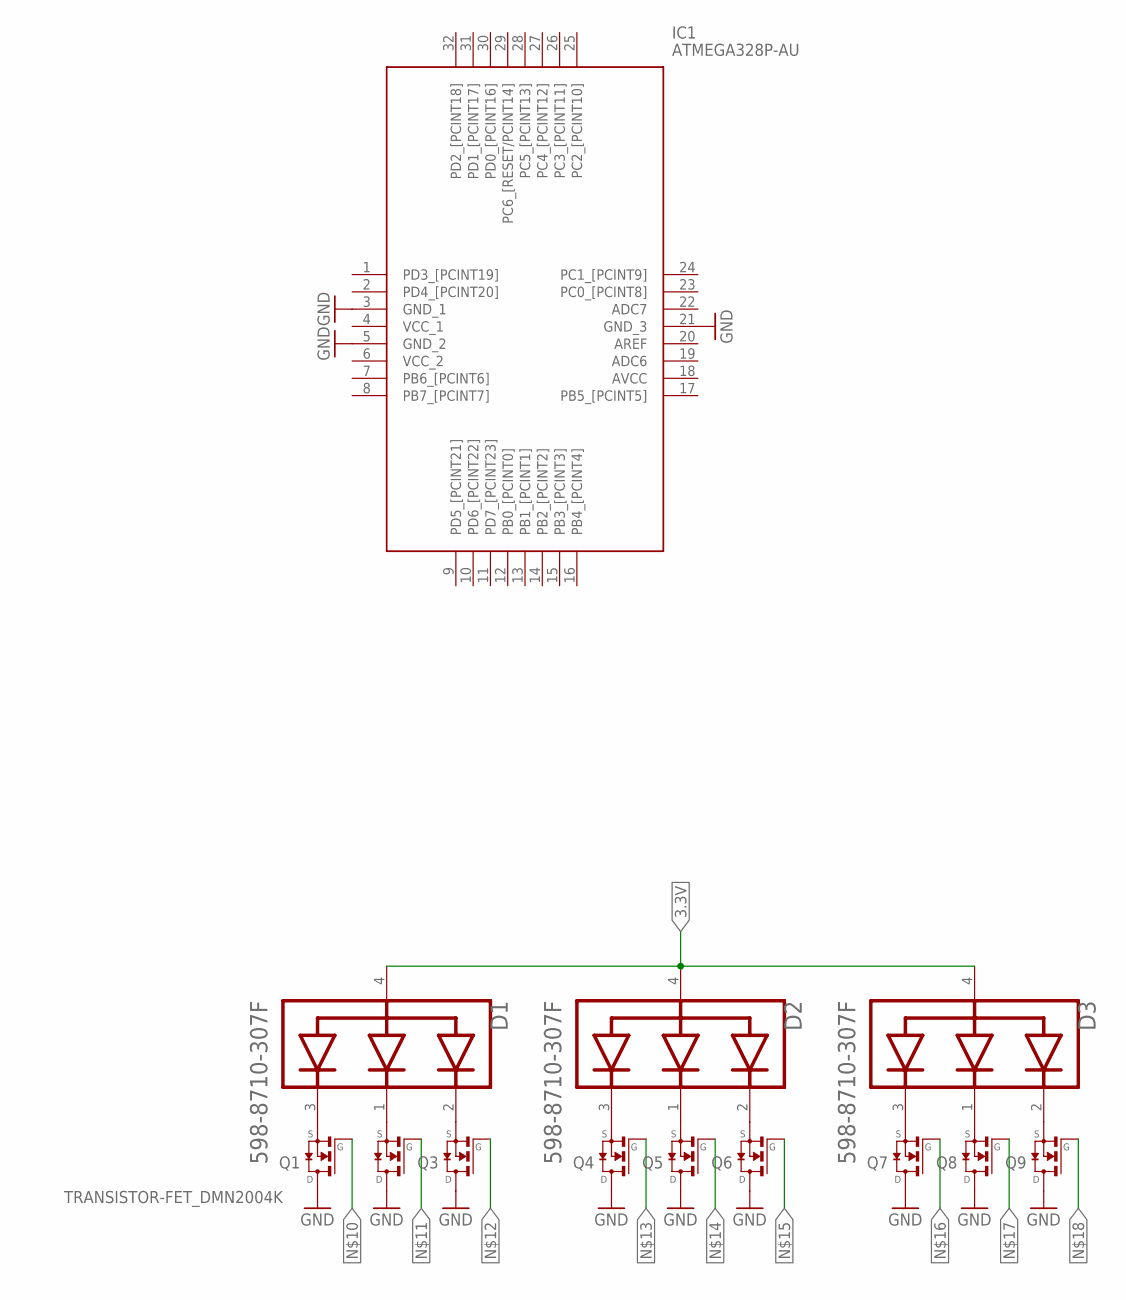
[picture p4: schematic LED's.sch]

Parts:
D1, D2, D3: DIALIGHT_598-8710-307FDIALIGHT_598-8710-307F_0_0; DIALIGHT_598-8710-307F_0
IC1: ATMEGA328P-AU; QFP80P900X900X120-32N
Q1, Q2, Q3, Q4, Q5, Q6, Q7, Q8, Q9: TRANSISTOR-FET_DMN2004K; TRANSISTOR-FET_SOT23

Connections:
3.3V: D1.4 (COMMON_ANODE), D2.4 (COMMON_ANODE), D3.4 (COMMON_ANODE)
GND: IC1.3 (GND_1), IC1.5 (GND_2), IC1.21 (GND_3), Q1.3 (D), Q2.3 (D), Q3.3 (D), Q4.3 (D), Q5.3 (D), Q6.3 (D), Q7.3 (D), Q8.3 (D), Q9.3 (D)
unnamed: D1.3 (BLUE_CATHODE), Q1.2 (S)
unnamed: D1.1 (GREEN_CATHODE), Q2.2 (S)
unnamed: D1.2 (RED_CATHODE), Q3.2 (S)
unnamed: D2.3 (BLUE_CATHODE), Q4.2 (S)
unnamed: D2.1 (GREEN_CATHODE), Q5.2 (S)
unnamed: D2.2 (RED_CATHODE), Q6.2 (S)
unnamed: D3.3 (BLUE_CATHODE), Q7.2 (S)
unnamed: D3.1 (GREEN_CATHODE), Q8.2 (S)
unnamed: D3.2 (RED_CATHODE), Q9.2 (S)
