OLLYDOTDEV/Project-Birdseye-DTX-2020/Schematics/PCBS/ROMS.sch

## EAGLE design Schematics/PCBS/ROMS.sch (2020-08-30)

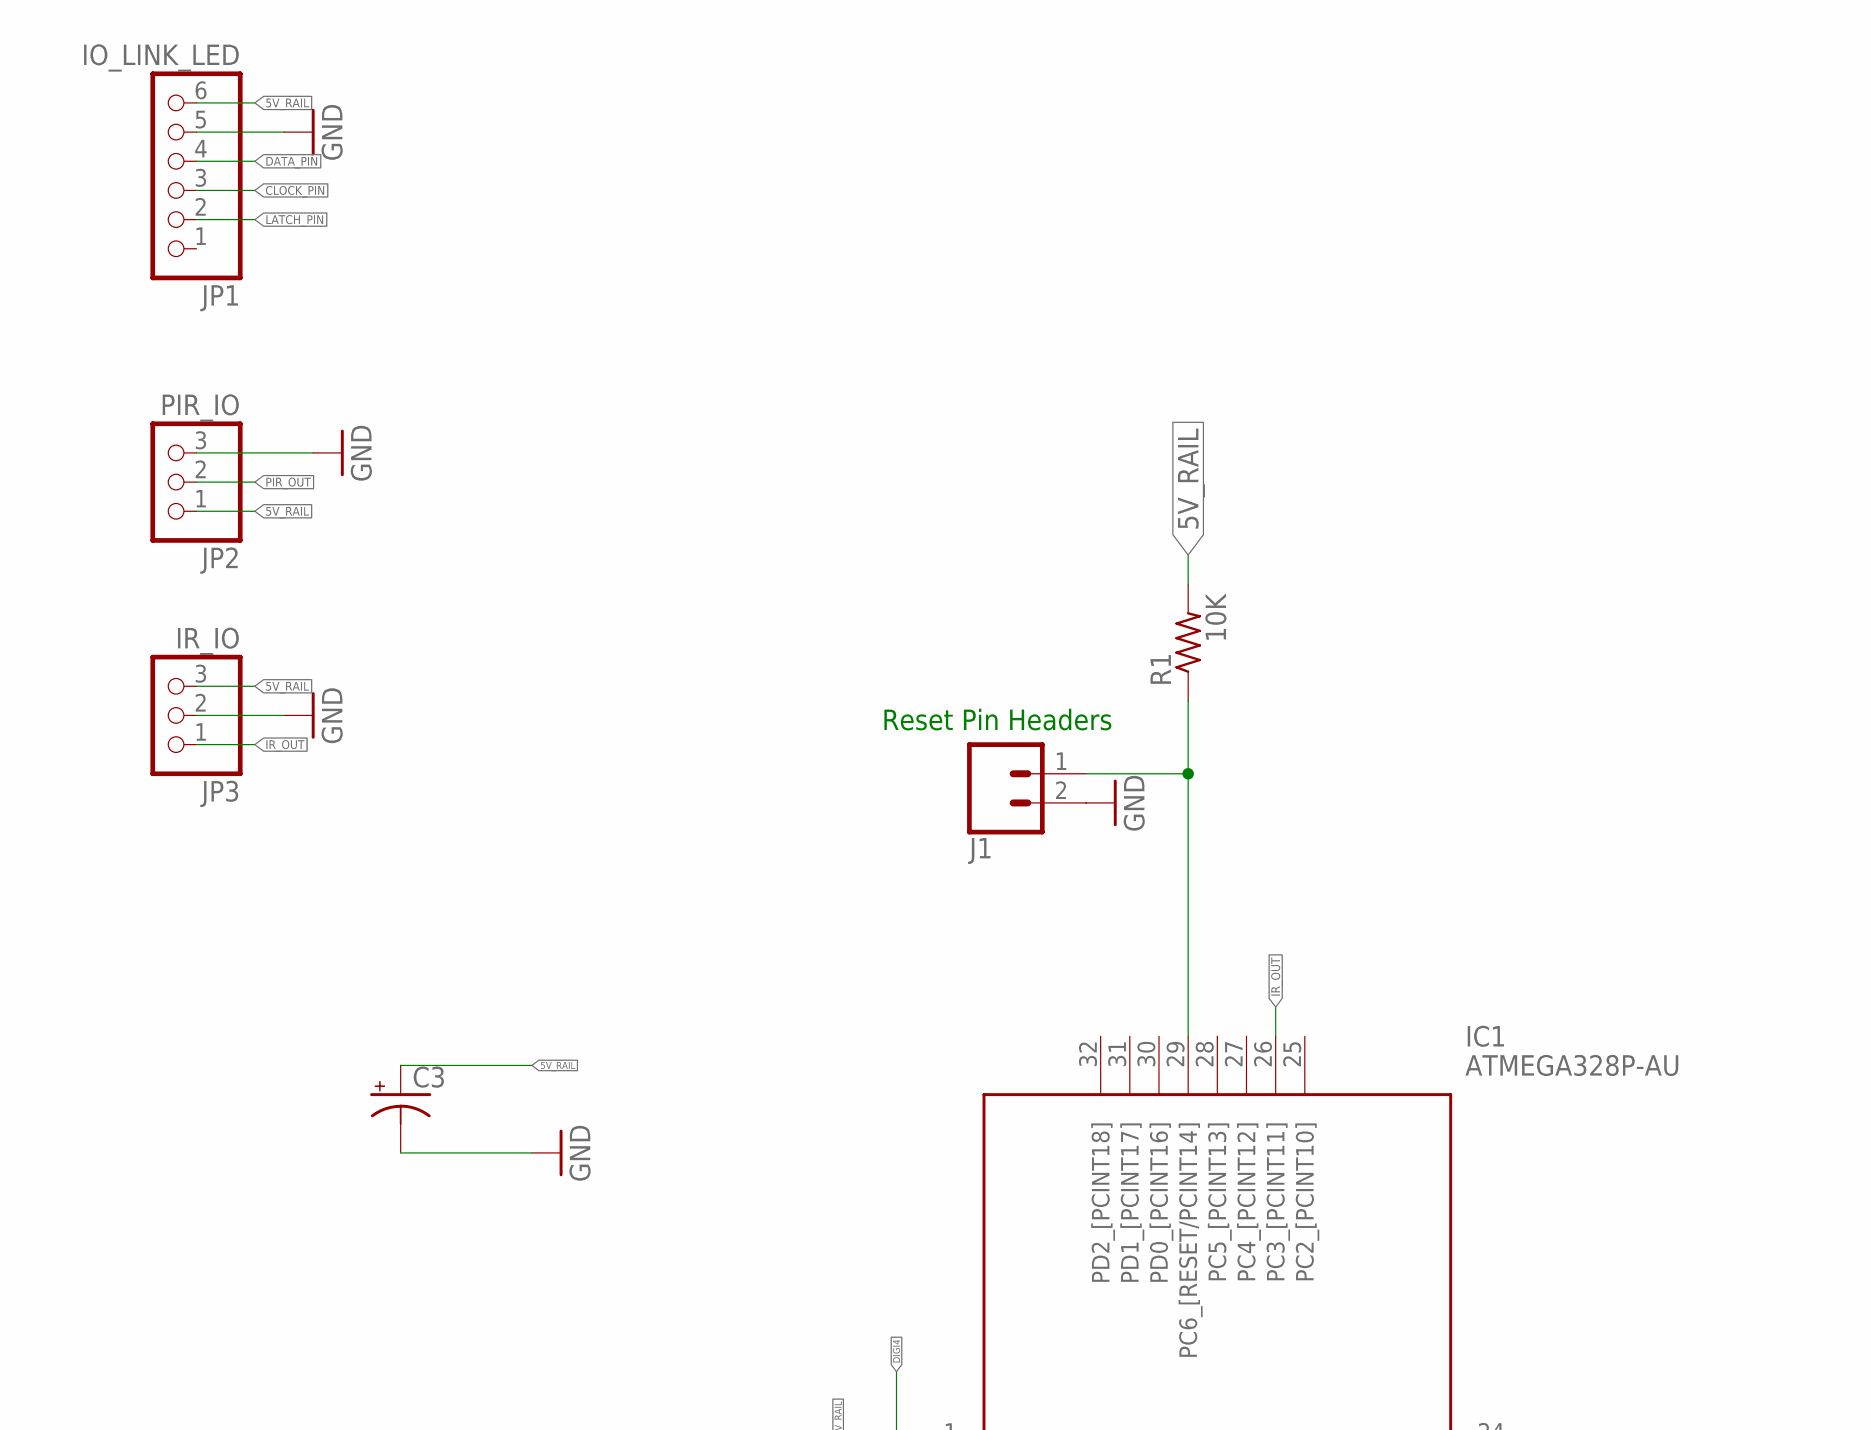
[picture p5: schematic ROMS.sch, part in row 1, column 1]

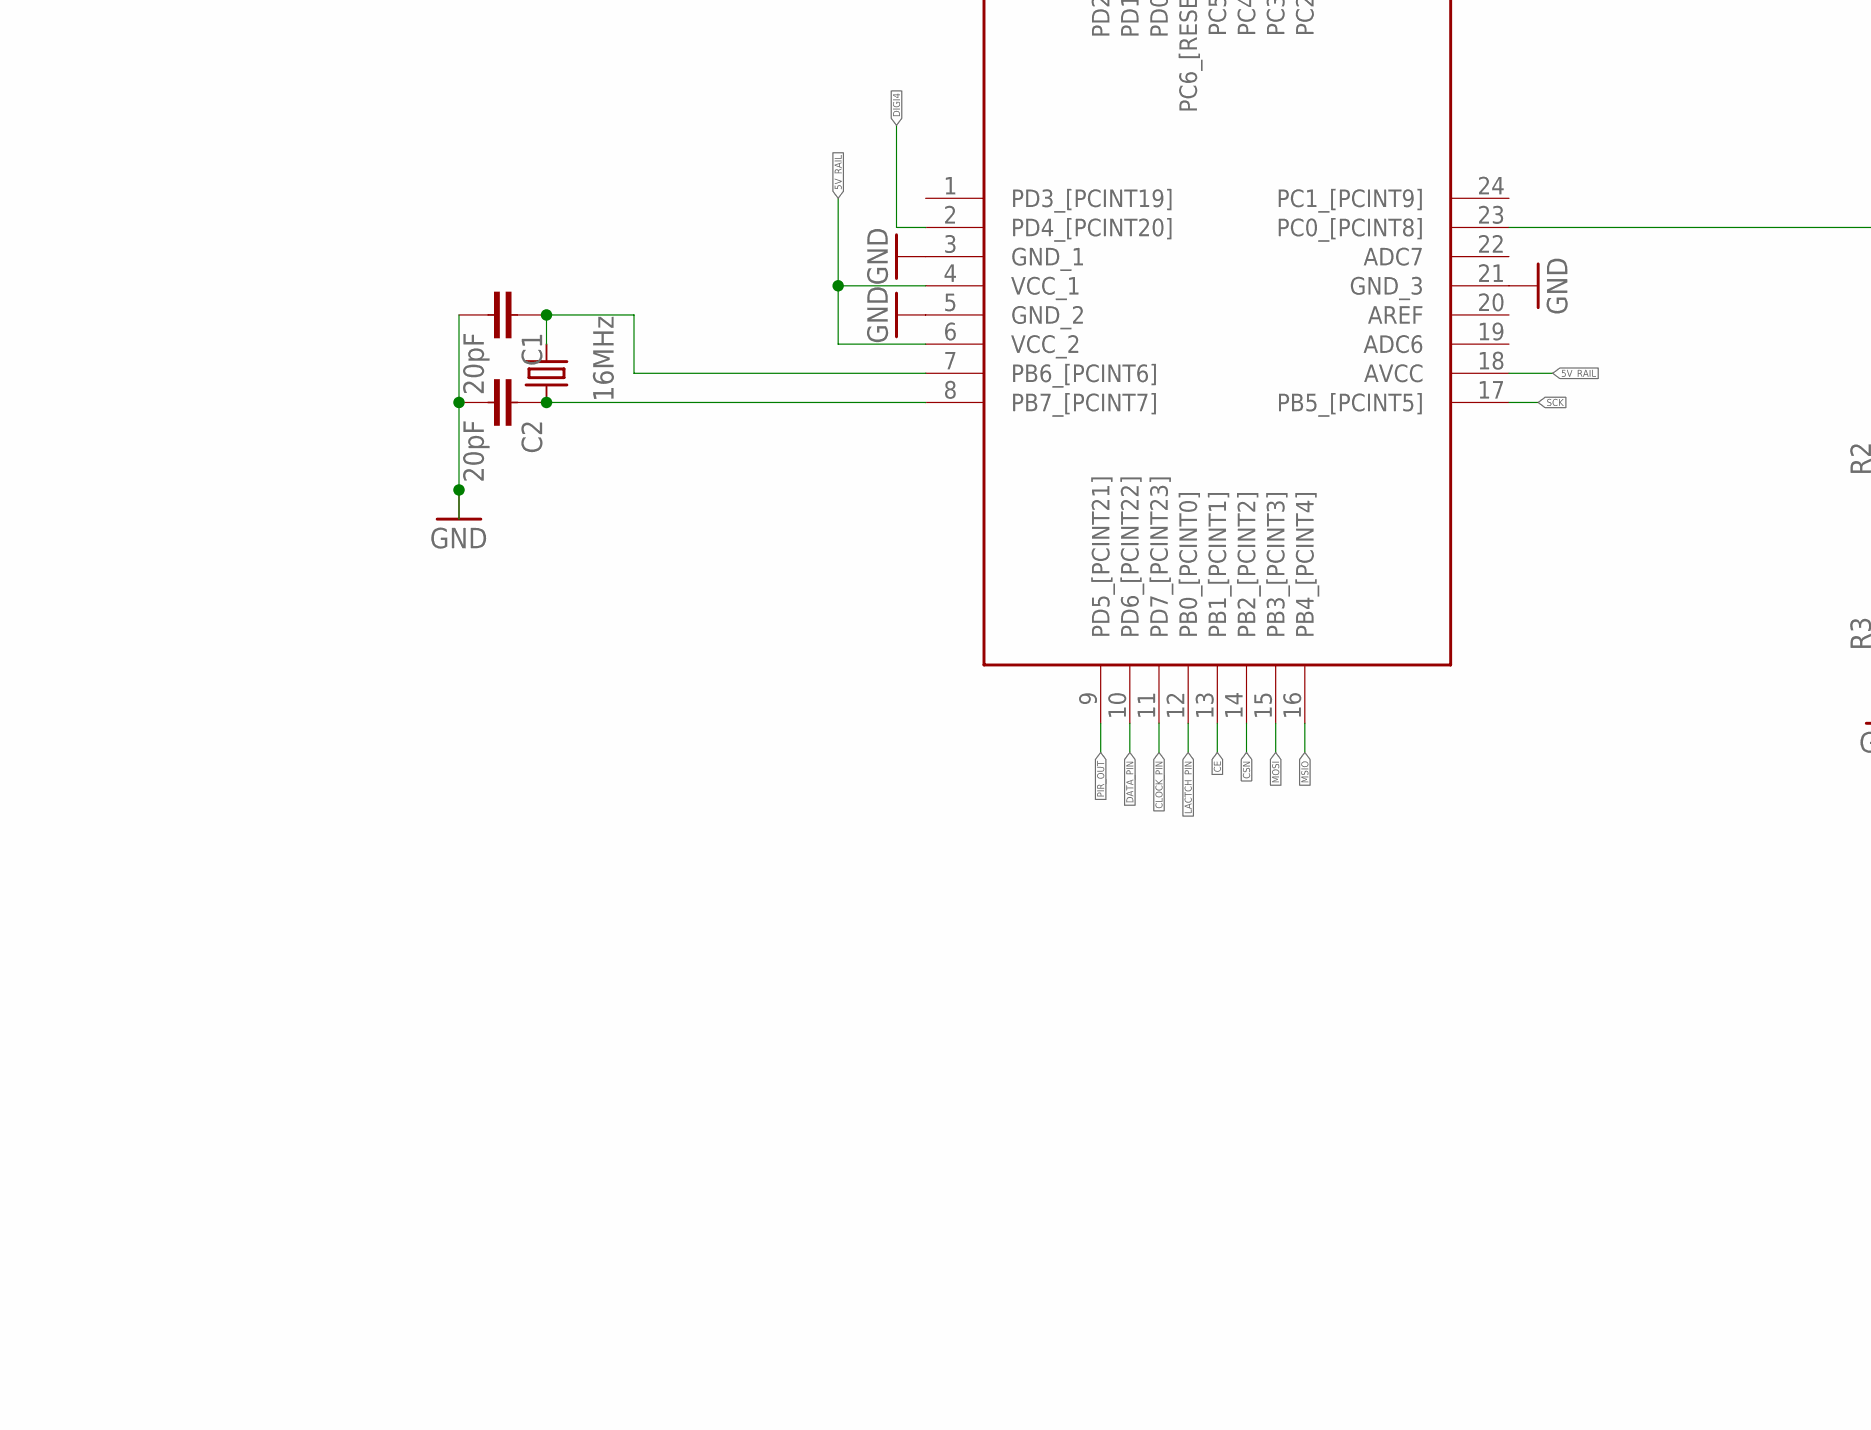
[picture p6: schematic ROMS.sch, part in row 2, column 1]

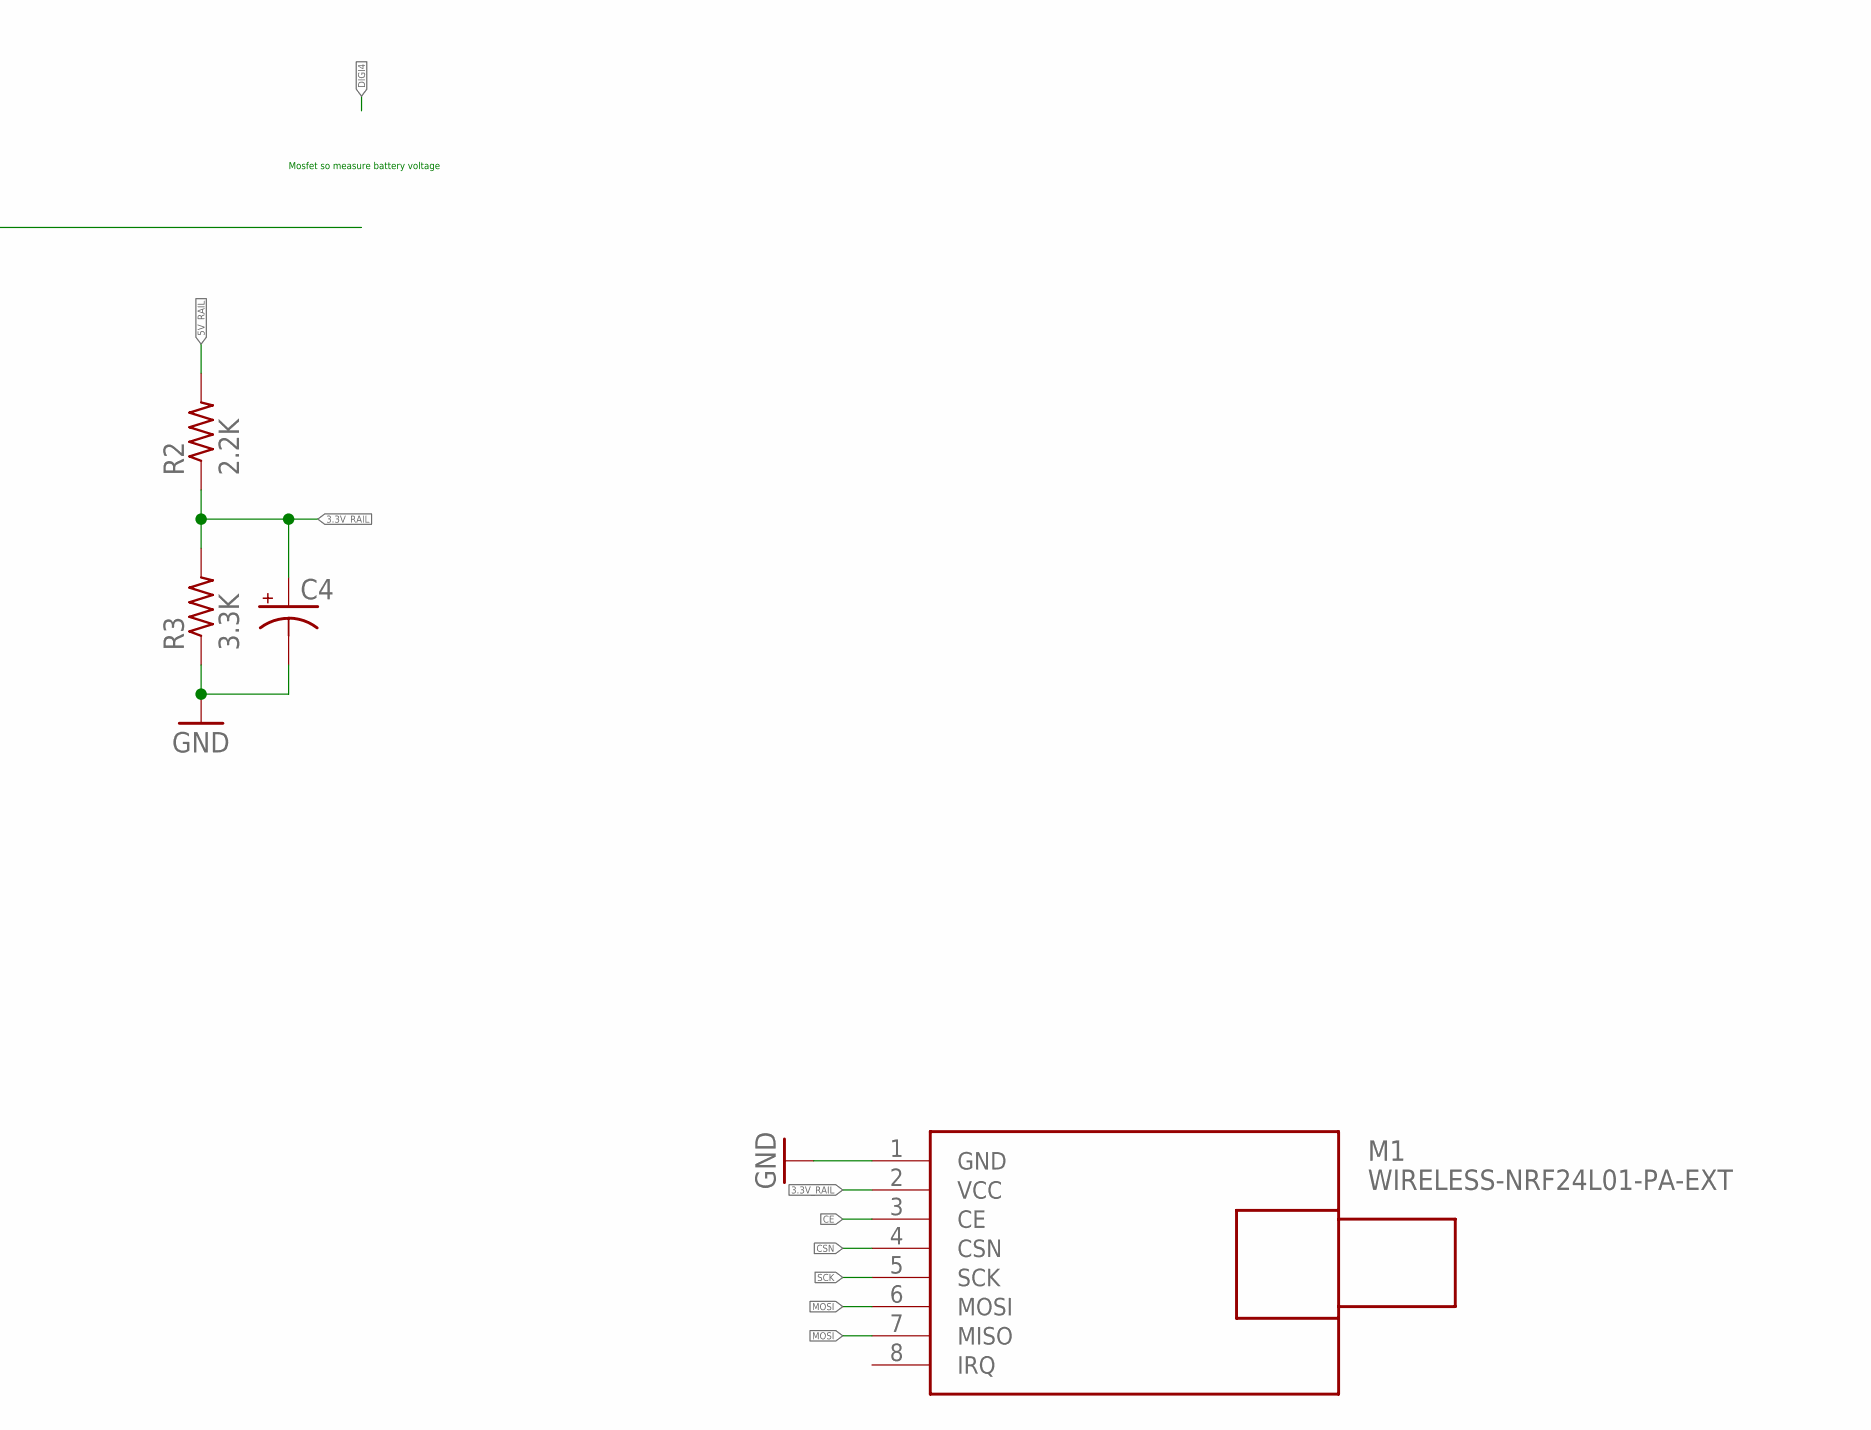
[picture p7: schematic ROMS.sch, part in row 2, column 2]

Parts:
C1, C2: 20pF; 0402-TIGHT
C3, C4: CPOL-USTT2D5; TT2D5
IC1: ATMEGA328P-AU; QFP80P900X900X120-32N
J1: CONN_02; 1X02
JP1: IO_LINK_LED; 1X06
JP2: PIR_IO; 1X03
JP3: IR_IO; 1X03
M1: WIRELESS-NRF24L01-PA-EXT; WIRELESS-NRD24L01-PA-EXT
R1: 10K; 0207/10
R2: 2.2K; 0805-THM
R3: 3.3K; 0805-THM
Y1: 16MHz; HC49US

Connections:
3.3V_RAIL: C4.+, M1.2 (VCC), R2.1, R3.2
5V_RAIL: C3.+, IC1.4 (VCC_1), IC1.6 (VCC_2), IC1.18 (AVCC), JP1.6, JP2.1, JP3.3, R1.2, R2.2
CE: IC1.13 (PB1_[PCINT1]), M1.3 (CE)
CLOCK_PIN: IC1.11 (PD7_[PCINT23]), JP1.3
CSN: IC1.14 (PB2_[PCINT2]), M1.4 (CSN)
DATA_PIN: IC1.10 (PD6_[PCINT22]), JP1.4
DIGI4: IC1.2 (PD4_[PCINT20])
GND: C1.2, C2.2, C3.-, C4.-, IC1.3 (GND_1), IC1.5 (GND_2), IC1.21 (GND_3), J1.2, JP1.5, JP2.3, JP3.2, M1.1 (GND), R3.1
IR_OUT: IC1.26 (PC3_[PCINT11]), JP3.1
LACTCH_PIN: IC1.12 (PB0_[PCINT0])
LATCH_PIN: JP1.2
MOSI: IC1.15 (PB3_[PCINT3]), M1.6 (MOSI), M1.7 (MISO)
MSIO: IC1.16 (PB4_[PCINT4])
unnamed: C1.1, IC1.7 (PB6_[PCINT6]), Y1.2
unnamed: C2.1, IC1.8 (PB7_[PCINT7]), Y1.1
unnamed: IC1.29 (PC6_[RESET/PCINT14]), J1.1, R1.1
PIR_OUT: IC1.9 (PD5_[PCINT21]), JP2.2
SCK: IC1.17 (PB5_[PCINT5]), M1.5 (SCK)

Notes on the sheet:
Reset Pin Headers
Mosfet so measure battery voltage
