OLLYDOTDEV/Project-Birdseye-DTX-2020/Schematics/PCBS/RPI.sch

## EAGLE design Schematics/PCBS/RPI.sch (2020-09-09)

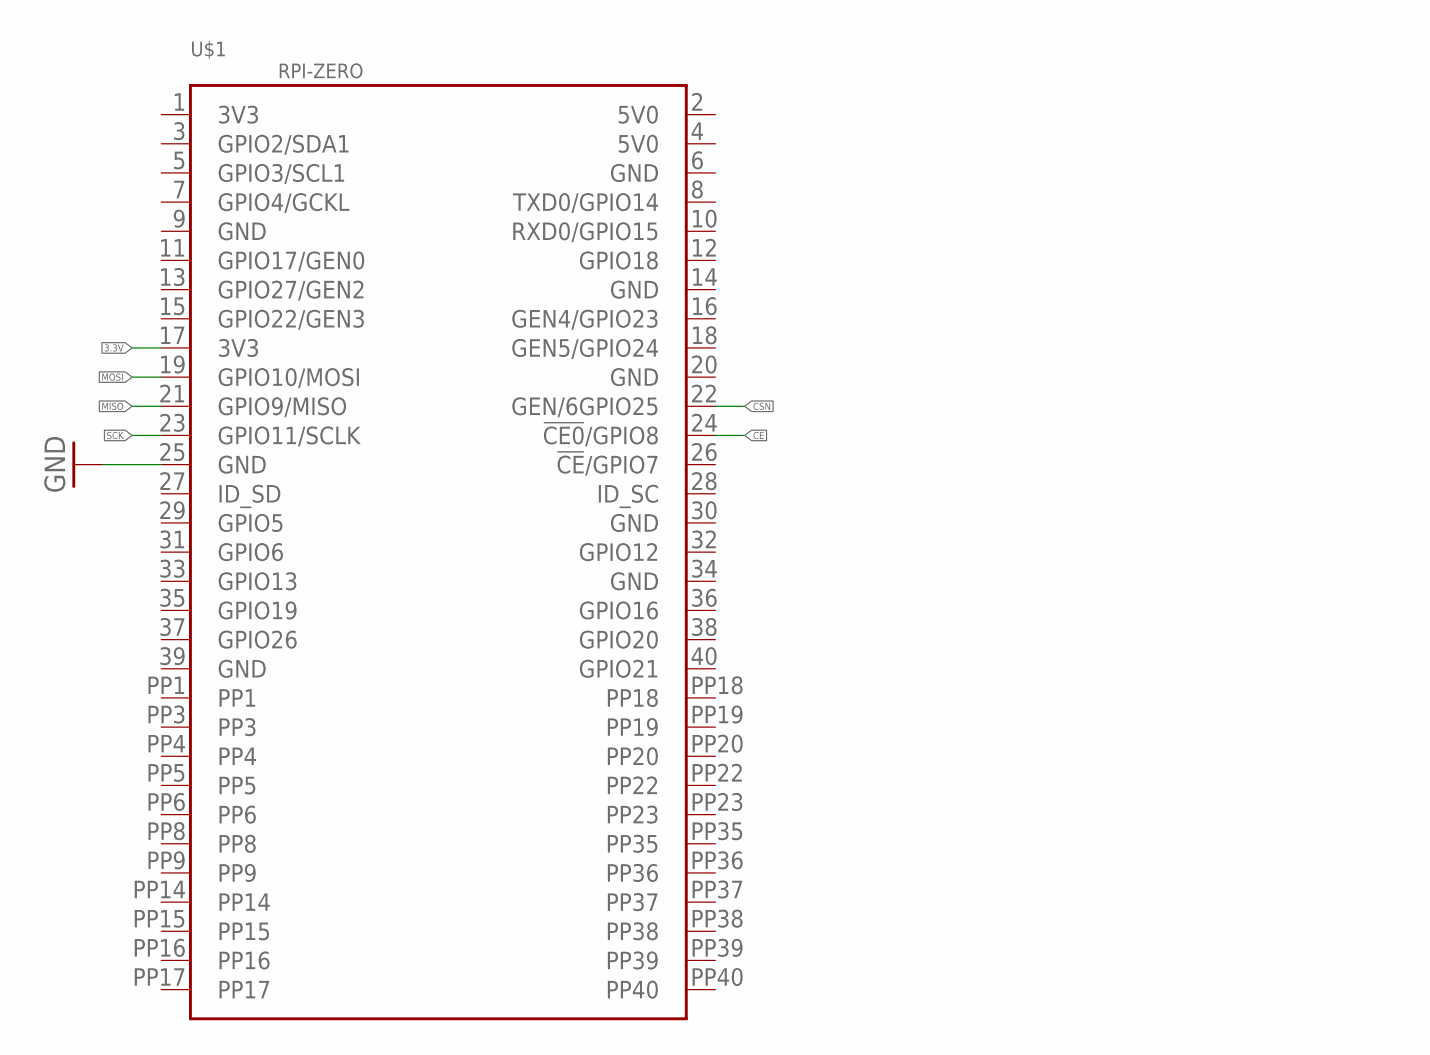
[picture p8: schematic RPI.sch, part in row 1, column 1]

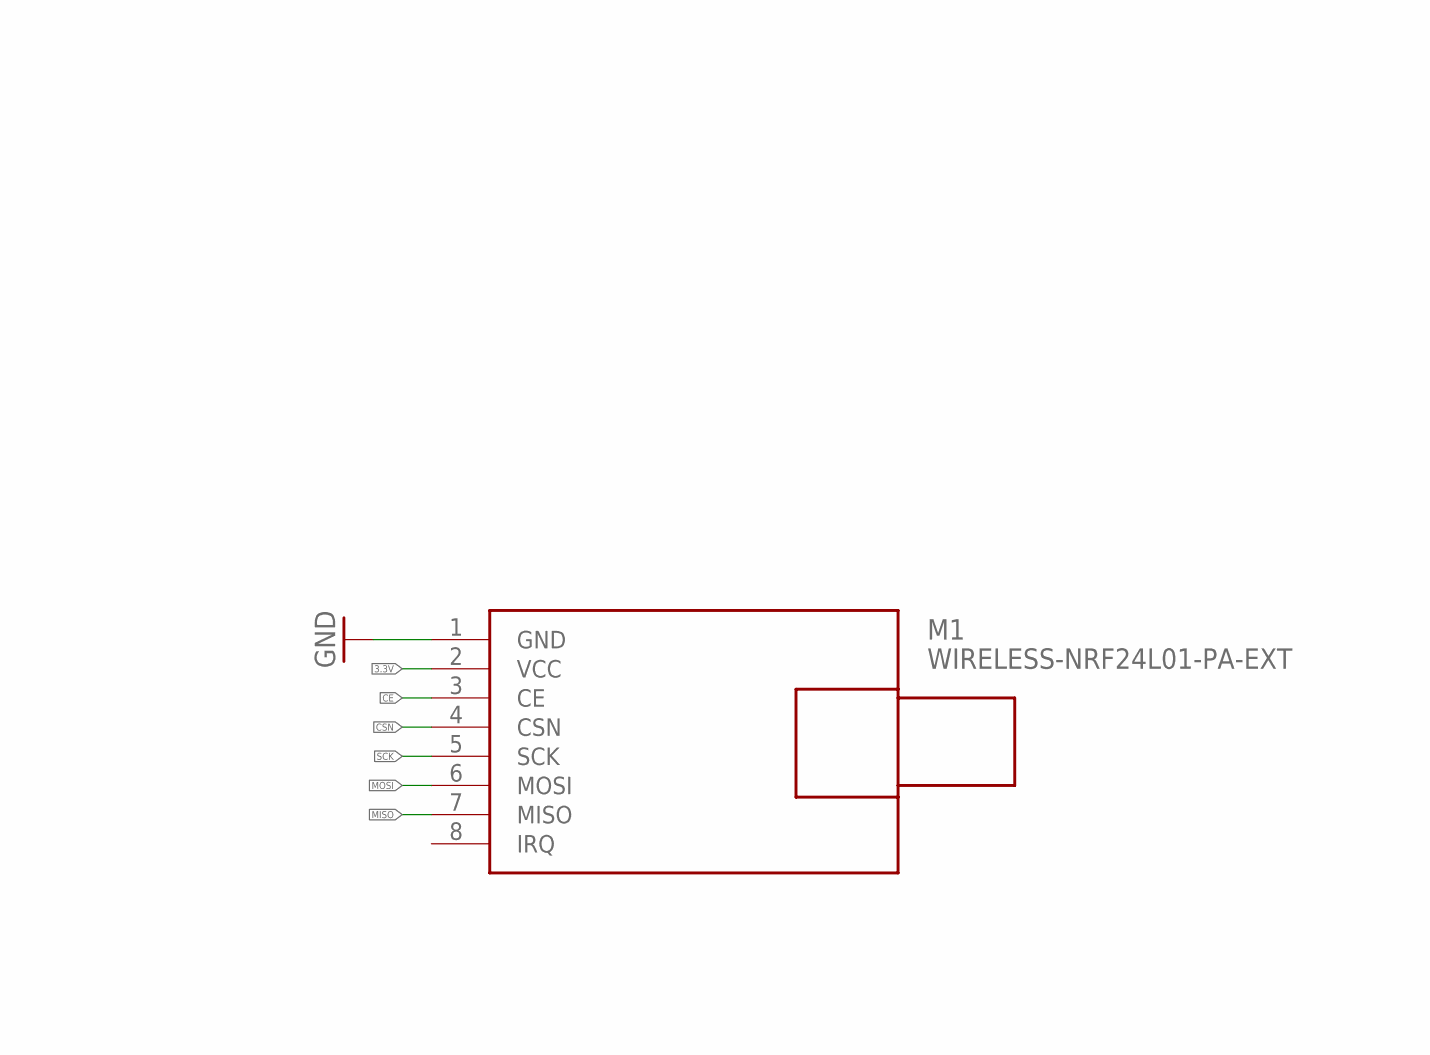
[picture p9: schematic RPI.sch, part in row 1, column 2]

Parts:
M1: WIRELESS-NRF24L01-PA-EXT; WIRELESS-NRD24L01-PA-EXT
U$1: RPI-ZERO; RASP_PI_ZERO_BOARD_FULL

Connections:
3.3V: M1.2 (VCC), U$1.17 (3V3)
CE: M1.3 (CE), U$1.24 (!CE0!/GPIO8)
CSN: M1.4 (CSN), U$1.22 (GEN/6GPIO25)
GND: M1.1 (GND), U$1.25 (GND)
MISO: M1.7 (MISO), U$1.21 (GPIO9/MISO)
MOSI: M1.6 (MOSI), U$1.19 (GPIO10/MOSI)
SCK: M1.5 (SCK), U$1.23 (GPIO11/SCLK)
