OLLYDOTDEV/Project-Birdseye-DTX-2020/(commit log)

2020-02-09 Init Eagle Upload
    [ROMS.sch]
2020-02-10 added 16mhz +grounding
    [ROMS.sch]
2020-02-11 working on VCC power
    [ROMS.sch]
2020-02-12 Start of NRF24lo1 hook up & LED’s
    [ROMS.sch]
2020-02-12 removed LED from ROMS
    [ROMS.sch]
2020-02-13 school day back up
    [LED's.sch]
2020-02-21 led + atmega328
    [LED's.sch, ROMS.sch]
2020-02-24 added power rail and regulator
    [LEDs.sch]
2020-02-25 LT1763CS8-5TRPBF.lbr and LT1763CS8-3.3_TRPBF.lbr2. Also updated Regulator in LED PCB to the correct variant
    [LEDs.sch]
2020-02-26 update power Rail
    [LEDs.sch]
2020-02-26 completion of Of the first implementation of the power system
    [LEDs.sch]
2020-02-27 join Led To IC
    [LEDs.sch]
2020-02-27 connected LED Mosfets to IC + Add headers
    [LEDs.sch]
2020-02-27 Fix layout issues via fix to grid
    [LEDs.sch, ROMS.sch]
2020-03-01 updated Fauly .lbr as the N channel MOSFETS has a labels on the SOT-23-3
2020-03-01 started on Bidirectional Logic Level Converter
    [LEDs.sch]
2020-03-02 Added RXD Logic level converter && IO update
    [LEDs.sch]
2020-03-05 updated RXD_IN 5v to 3.3v
    [LEDs.sch]
2020-03-05 LEDs.sch -> LC_Board.sch
    [LC_Board.sch]
2020-03-05 update .gitignore && added MOSFET value to board
    [LC_Board.sch]
2020-03-05 removed old LED .sch
2020-03-08 updated IO
    [LC_Board.sch]
2020-03-08 3.3v && 5v selcetor headers added
    [LC_Board.sch]
2020-03-09 added lables to 5v to 3.3v on RXI
    [LC_Board.sch]
2020-03-09 Added lables to LC_board led gnd control mostfets
    [LC_Board.sch]
2020-03-10 PCB layout fixed
    [LC_Board.sch]
2020-03-10 added PCB .BRD file
    [LC_Board.brd]
2020-03-10 updated Reset_pull footprint to 603 from 403
    [LC_Board.sch]
2020-03-10 routing for PCB 1 ok outcome
    [LC_Board.brd, LC_Board.sch]
2020-03-12 LC_board PCB pos nearing finish for R1
    [LC_Board.brd, LC_Board.sch]
2020-03-13 back up be for remixing LED pos
    [LC_Board.brd]
2020-03-13 Syncing schematic with board fixed
    [LC_Board.brd, LC_Board.sch]
2020-03-15 weekend backup
    [LC_Board.brd]
2020-03-15 R1 Finish (yet to test)
    [LC_Board.brd]
2020-06-17 added Schematics/libraries/STP16C596M.lbr
2020-06-17 updated LC_Board IO to match need pins for Shift registers
    [LC_Board.brd, LC_Board.sch]
2020-06-20 added voltage divider and input pins Shift Register
    [LC_Board.brd, LC_Board.sch]
2020-06-22 connected LED & IO to Shift register
    [LC_Board.sch]
2020-06-28 added header pins for IR Sensor
    [ROMS.sch]
2020-07-18 PIR sensor test
    [ROMS.sch]
2020-07-19 Full Trigger test part started with just base PIR code
    [ROMS.sch]
2020-07-22 Smoothing class test ERROR
    [ROMS.sch]
2020-07-23 FUll Sensor test working with boot info error
    [Full_Trigger_Test.ino]
2020-07-24 fixed load value error
    [Full_Trigger_Test.ino, Smoothing_class_test.ino]
2020-07-24 fixed false alert when in boot with temp return value
    [Full_Trigger_Test.ino]
2020-07-24 input data count working = IR sensor full working
2020-07-28 added missing LED PCB link
    [ROMS.sch]
2020-07-29 added volage divider for NRF24
    [ROMS.sch]
2020-08-03 connected NRF24 to ATMEGA328p
    [ROMS.sch]
2020-08-10 added *3 AA battery holder and battery holder .lbr
2020-08-19 setup for RX|TX wireless code
2020-08-30 started implementing radio transmitting waiting for available transmission slot
2020-08-30 added Aluminum Electrolytic Capacitor for stabilizing power
    [ROMS.sch]
2020-09-04 added border case protection error checking
    [BULK_READ.ino, BULK_SEND.ino]
2020-09-04 added custom data structures + border case packet protection
2020-09-09 Improvements to Wireless data processing
2020-09-09 RPI sch
    [RPI.sch]
2020-09-10 added header and mode switch
2020-09-10 added Wireless data processing (not tested yet)
2020-09-10 updated switch cases
2020-09-17 fixed compile error:Transmitting...RF24 HARDWARE FAIL: Radio not responding, verify pin connections, wiring, etc.
2020-09-21 sensor control added
2020-09-21 sensor mode enable|disable added and working (tested)
2020-10-19 NCEA Docs
    [2020 DTX For Oliver.xlsx]
